bminch/smu2/README.md

# smu2
USB Source Measure Unit Design Files and Source Code
