bminch/smu2/board/smu2_BoM.ods

Item | Reference Designators | Value | Description | Qty | Digikey Catalog # | Manufacturer Part #
1 | C4, C5, C6, C7, C8, C9, C14, C18, C19, C20, C21, C22, C23, C24, C25, C26, C27, C28, C29, C30, C31, C33, C34, C35, C36, C37, C38, C39, C40, C41, C42, C43, C44, C45, C46, C47, C48, C49, C50, C52, C53, C54, C55, C58, C69 | 0.1µF | 0.1µF ceramic cap, 0603, ±5%, X7R, 50V | 45 | 1276-1033-1-ND | CL10B104JB8NNNC
2 | C1, C15, C16, C17, C56, C57, C59, C63, C64, C67, C68 | 10µF | 10µF ceramic cap, 0603, ±10%, X5R, 25V | 11 | 490-18214-1-ND | GRM188R61E106KA73D
3 | C10, C11, C12, C13 | 1µF | 1µF ceramic cap, 0603, ±10%, X7R, 25V | 4 | 1276-1184-1-ND | CL10B105KA8NNNC
4 | C60, C65, C66 | 10nF | 10nF ceramic cap, 0603, ±5%, X7R, 50V | 3 | 399-C0603C103J5RAC7867CT-ND | C0603C103J5RAC7867
5 | C2, C3 | 22pF | 22pF ceramic cap, 0603, ±1%, C0G/NP0, 50V | 2 | 1292-1500-1-ND | 0603N220F500CT
6 | C32, C51 | 1nF | 1nF ceramic cap, 0603, ±1%, C0G/NP0, 50V | 2 | 478-KGM15ACG1H102FTCT-ND | KGM15ACG1H102FT
7 | C61 | 220nF | 220nF ceramic cap, 0603, ±10%, X7R, 50V | 1 | 445-7408-1-ND | C1608X7R1H224K080AB
8 | C62 | 4.7nF | 4.7nF ceramic cap 0603, ±10%, X7R, 50V | 1 | 1276-1098-1-ND | CL10B472KB8NNNC
9 | R11, R12, R14, R16, R21, R22, R23, R24, R25, R26, R39, R41, R46, R47, R48, R49, R50, R51, R71, R72, R73, R74 | 2kΩ | 2kΩ resistor, 0603, ±0.1%, 1/10W | 22 | P2.0KDBCT-ND | ERA-3AEB202V
10 | R2, R4, R5, R6, R7, R9, R63 | 5.1kΩ | 5.1kΩ resistor, 0603, ±1%, 1/10W | 7 | P5.10KHCT-ND | ERJ-3EKF5101V
11 | R19, R20, R29, R44, R45, R54 | 1kΩ | 1kΩ resistor, 0603, ±0.1%, 1/10W | 6 | P1.0KDBCT-ND | ERA-3AEB102V
12 | R17, R18, R42, R43, R70 | 12.7kΩ | 12.7kΩ resistor, 0603, ±1%, 1/10W | 5 | 311-12.7KHRCT-ND | RC0603FR-0712K7L
13 | R1, R3, R10, R65 | 909Ω | 909Ω resistor, 0603, ±1%, 1/10W | 4 | 311-909HRCT-ND | RC0603FR-07909RL
14 | R13, R15, R38, R40 | 255Ω | 255Ω resistor, 0603, ±0.1%, 1/10W | 4 | P255DBCT-ND | ERA-3AEB2550V
15 | R30, R34, R55, R59 | 316Ω | 316Ω resistor, 0603, ±0.1%, 1/10W | 4 | P316DBCT-ND | ERA-3AEB3160V
16 | R31, R35, R56, R60 | 10kΩ | 10kΩ resistor, 0603, ±0.1%, 1/10W | 4 | P10KDBCT-ND | ERA-3AEB103V
17 | R32, R36, R57, R61 | 316kΩ | 316kΩ resistor, 0603, ±0.1%, 1/10W | 4 | P316KDBCT-ND | ERA-3AEB3163V
18 | R33, R37, R58, R62 | 10MΩ | 10MΩ resistor, 1206, ±0.1%, 1/4W | 4 | 749-MCA1206MD1005BP100CT-ND | MCA1206MD1005BP100
19 | R8, R66 | 105kΩ | 105kΩ resistor, 0603, ±1%, 1/10W | 2 | 311-105KHRCT-ND | RC0603FR-07105KL
20 | R27, R52 | 909kΩ | 909kΩ resistor, 0603, ±1%, 1/10W | 2 | 311-909KHRCT-ND | RC0603FR-07909KL
21 | R28, R53 | 9.09kΩ | 9.09kΩ resistor, 0603, ±0.1%, 1/10W | 2 | P9.09KDBCT-ND | ERA-3AEB9091V
22 | R64 | 100Ω | 100Ω resistor, 0603, ±1%, 1/10W | 1 | 311-100HRCT-ND | RC0603FR-07100RL
23 | R67 | 1.3MΩ | 1.3MΩ resistor, 0603, ±1%, 1/10W | 1 | YAG3326CT-ND | RC0603FR-071M3L
24 | R68 | 976kΩ | 976kΩ resistor, 0603, ±1%, 1/10W | 1 | 311-976KHRCT-ND | RC0603FR-07976KL
25 | R69 | 86.6kΩ | 86.6kΩ resistor, 0603, ±1%, 1/10W | 1 | 311-86.6KHRCT-ND | RC0603FR-0786K6L
26 | L1, L2 | 4.7µH | PA5003.182NLT | 2 | 553-4090-1-ND | PA5003.472NLT
27 | D4, D5 | SD0805S020S1R0 | 0805, 20V, 1A, Schottky diode | 2 | 478-7800-1-ND | SD0805S020S1R0
28 | D1 | RGB | IN-S85TATRGB | 1 | 1830-1086-1-ND | IN-S85TATRGB
29 | D2, D6 | BLE, ±12V | 0805, Blue LED | 2 | 1497-XZCFBB54W-1VFCT-ND | XZCFBB54W-1VF
30 | D3 | 3V3 | 0805, Green LED | 1 | 160-1887-1-ND | LTST-C170TGKT
31 | U6, U7, U9, U10, U15, U16, U18, U19 | AD8420 | MSOP-8, 3x3mm, 0.65mm pitch | 8 | 505-AD8420ARMZ-R7CT-ND | AD8420ARMZ-R7
32 | U11, U12, U20, U21 | ADG509F | TSSOP-16, 4.4x5mm, 0.65mm pitch | 4 | 505-ADG5209FBRUZ-RL7CT-ND | ADG5209FBRUZ-RL7
33 | U2, U3 | ADS8887 | TSSOP-10, 3x3mm, 0.5mm pitch | 2 | 296-37909-5-ND | ADS8887IDGS
34 | U8, U17 | ADG333A | SSOP-20, 5.3x7.2mm, 0.65mm pitch | 2 | ADG333ABRSZ-REELCT-ND | ADG333ABRSZ-REEL
35 | U13, U22 | AD823A | MSOP-8, 3x3mm, 0.65mm pitch | 2 | 505-AD823AARMZ-ND | AD823AARMZ
36 | U14, U23 | ADG1221 | MSOP-10, 3x3mm, 0.5mm pitch | 2 | 505-ADG1221BRMZ-REEL7CT-ND | ADG1221BRMZ-REEL7
37 | U1 | PIC24FJ128GC006 |  | 1 | PIC24FJ128GC006-I/MR-ND | PIC24FJ128GC006-I/MR
38 | U4 | DAC8564 | TSSOP-16, 4.4x5mm, 0.65mm pitch | 1 | 296-50721-1-ND | DAC8564IAPWR
39 | U5 | RN4871 | RN4871 | 1 | RN4871-I/RM130-ND | RN4871-I/RM130
40 | U24 | MCP1702T-3302E | SOT-23 | 1 | MCP1702T-3302E/CBCT-ND | MCP1702T-3302E/CB
41 | U25 | TPS65131-Q1 | TPS65131-Q_1 | 1 | 296-40865-1-ND | TPS65131TRGERQ1
42 | U26 | LT3032EDE-12 |  | 1 | LT3032EDE-12#PBF-ND | LT3032EDE-12#PBF
43 | U27 | MCP6022 | TSSOP-8, 4.4x3mm, 0.65mm pitch | 1 | MCP6022T-I/STCT-ND | MCP6022T-I/ST
44 | Y1 | 32.768kHz | Crystal_SMD_2012-2Pin_2.0x1.2mm | 1 | XC2738-CT-ND | ECS-.327-12.5-12R-C-TR
45 | Q1 | AOSS21115C | SOT-23 | 1 | 785-AOSS21115CCT-ND | AOSS21115C
46 | S1, S2 | RST, SW1 | KXT321LHS | 2 | CKN10778CT-ND | KTX 321 LHS
47 | J2 | USB4105-GF-A | USB4105-GF-A | 1 | 2073-USB4105-GF-ACT-ND | USB4105-GF-A
48 | J3, J4, J5, J6 | 2.54-mm pin header | 2 1x2, 2 1x6 2.54-mm vertical male pin headers | 1 | S1021E-36-ND | PBC36SABN
49 |  | USB cable | USB A to C cable, USB 2.0, 1m | 1 | 2987-DH-20M50052-ND | DH-20M50052
50 |  | Breadboard | Solderless breadboard | 1 | 438-1045-ND | TW-E40-1020
