bminch/smu2/board/Eclectronics/3dshapes/219-3M.STEP

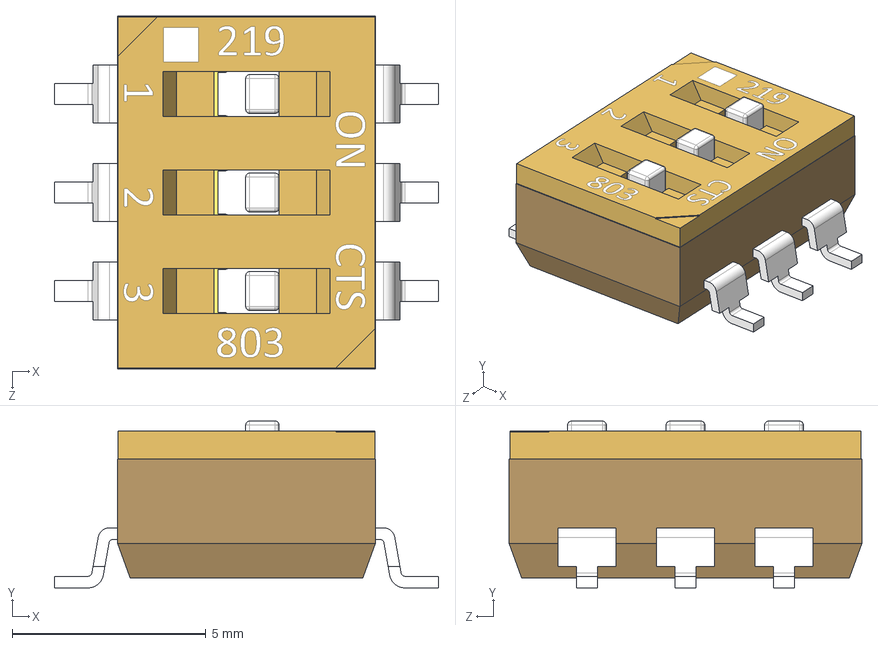
[picture p1: CAD file, 2025-06-17]
board/Eclectronics/3dshapes/219-3M.STEP
9.91 x 4.30 x 9.10 mm
