bminch/smu2/board/Eclectronics/3dshapes/STP_831056289_rev1.stp

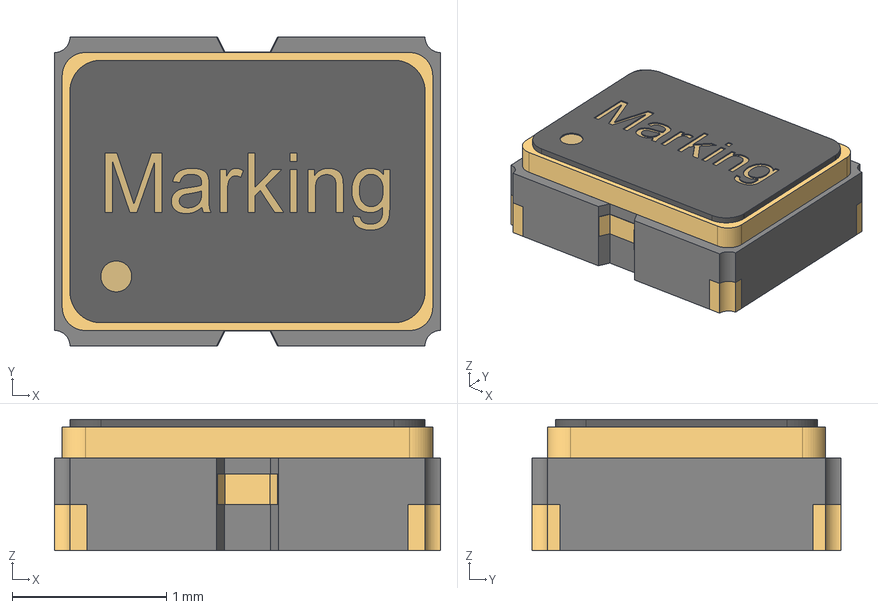
[picture p2: CAD file, 2025-06-17]
board/Eclectronics/3dshapes/STP_831056289_rev1.stp
2.50 x 2.00 x 0.85 mm
Pins
Cover
