bminch/smu2/board/Eclectronics/3dshapes/WS2812-2020.STEP

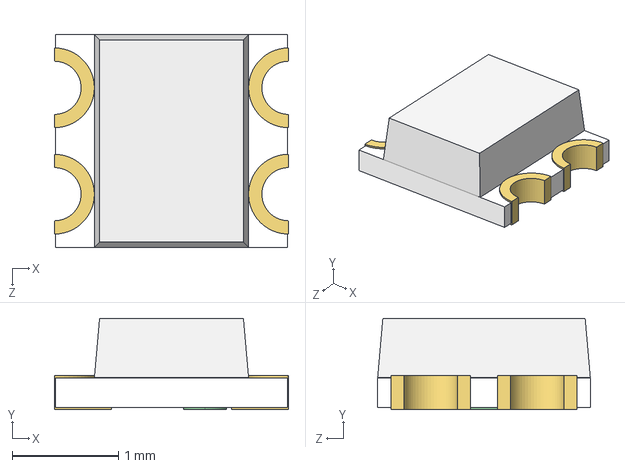
[picture p3: CAD file, 2025-06-17]
board/Eclectronics/3dshapes/WS2812-2020.STEP
2.20 x 0.86 x 2.00 mm
