bminch/smu2/board/Eclectronics/3dshapes/PA5003.182NLT.step

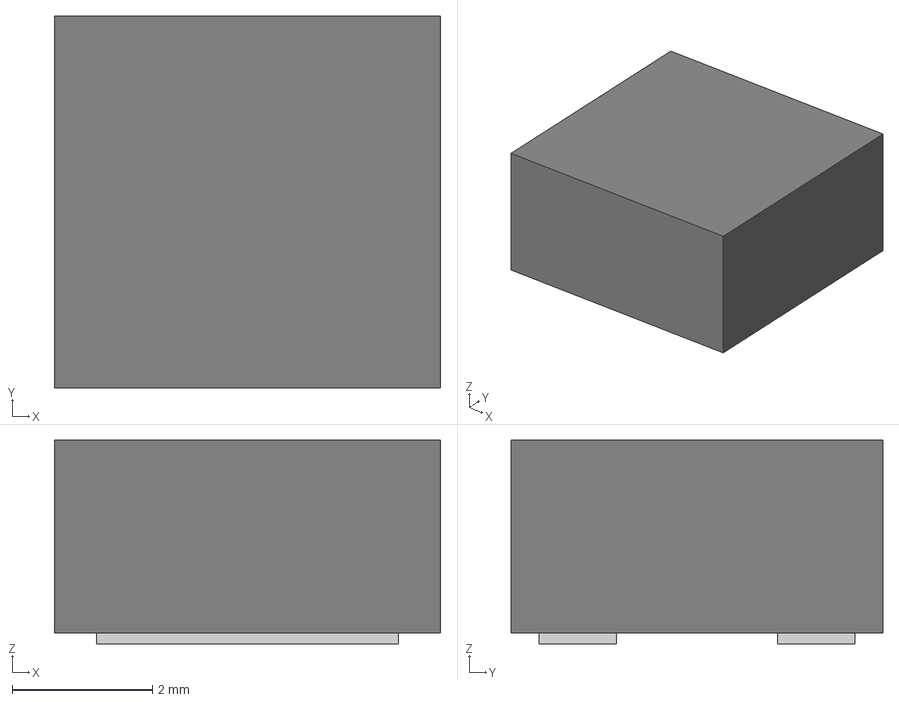
[picture p4: CAD file, 2025-06-17]
board/Eclectronics/3dshapes/PA5003.182NLT.step
5.50 x 5.30 x 2.90 mm
