bminch/smu2/board/Eclectronics/3dshapes/CUI_SDS-50J.step

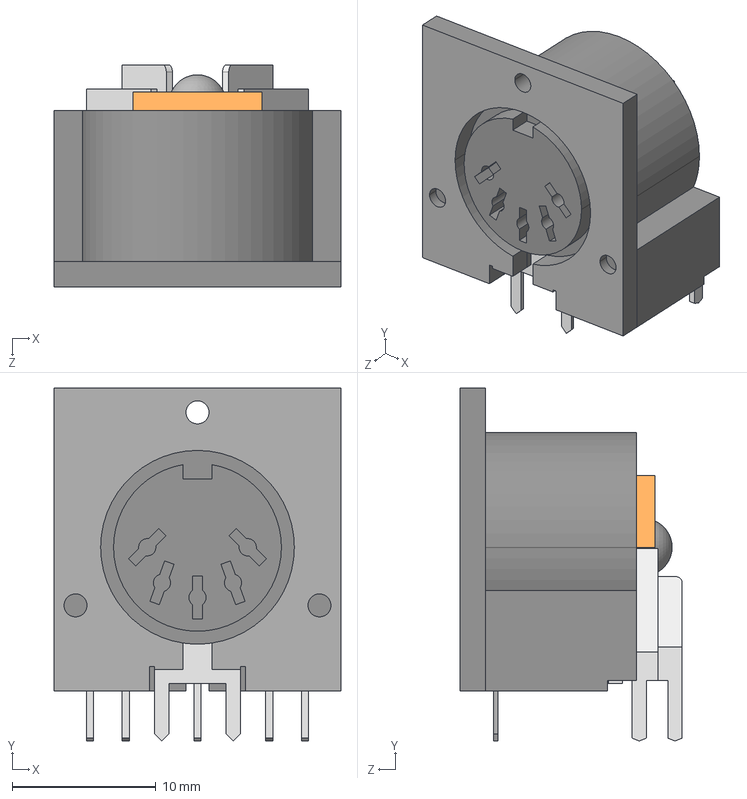
[picture p5: CAD file, 2025-06-17]
board/Eclectronics/3dshapes/CUI_SDS-50J.step
20.0 x 24.6 x 15.5 mm
