bminch/smu2/board/Eclectronics/3dshapes/WSON8-6x5.STEP

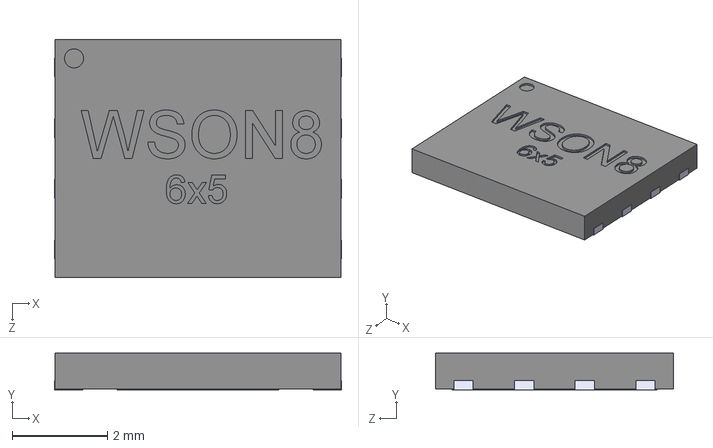
[picture p7: CAD file, 2025-06-17]
board/Eclectronics/3dshapes/WSON8-6x5.STEP
6.02 x 0.77 x 5.00 mm
