bminch/smu2/board/Eclectronics/3dshapes/DFN1006-2.stp

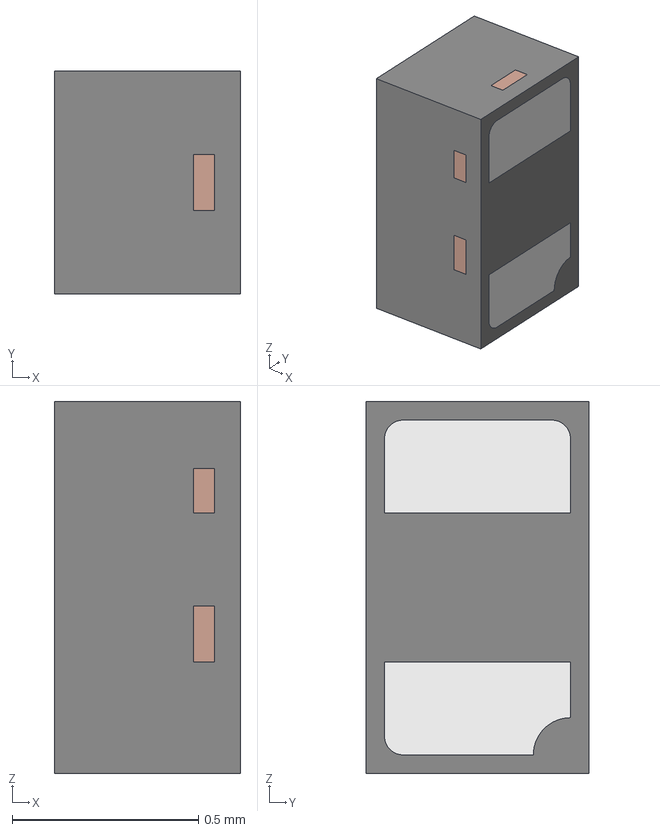
[picture p8: CAD file, 2025-06-17]
board/Eclectronics/3dshapes/DFN1006-2.stp
0.5 x 0.6 x 1.00 mm
LDF
