bminch/smu2/board/Eclectronics/3dshapes/EEEFTH101XAL.step

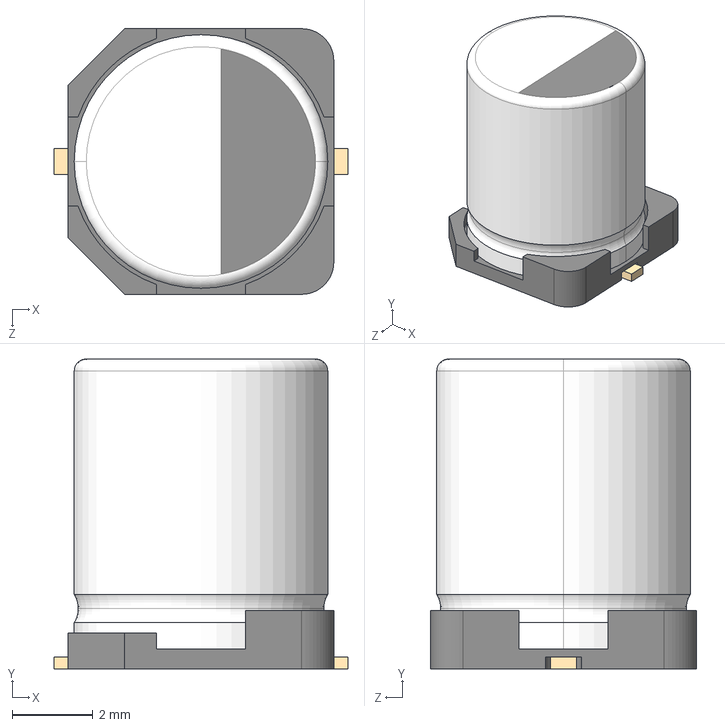
[picture p9: CAD file, 2025-06-17]
board/Eclectronics/3dshapes/EEEFTH101XAL.step
7.30 x 7.70 x 6.60 mm
