bminch/smu2/board/Eclectronics/3dshapes/ABM10.STP

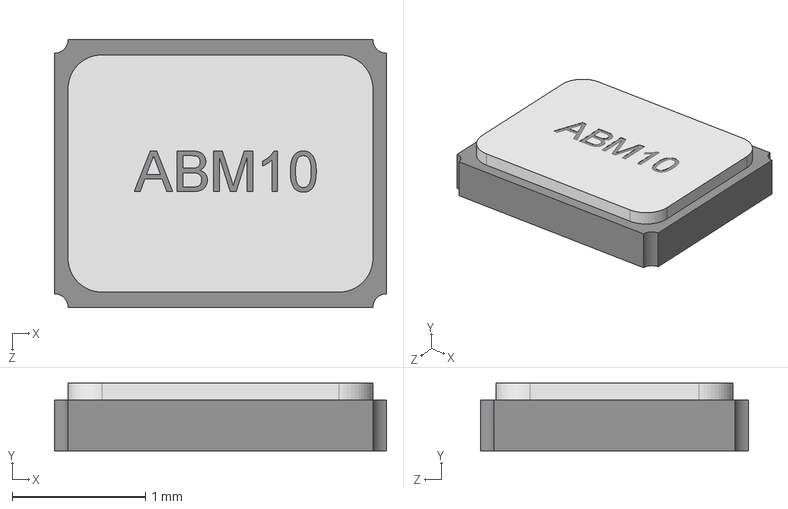
[picture p10: CAD file, 2025-06-17]
board/Eclectronics/3dshapes/ABM10.STP
2.49 x 0.508 x 2.01 mm
