bminch/smu2/board/Eclectronics/3dshapes/3382g-001-xxx.stp

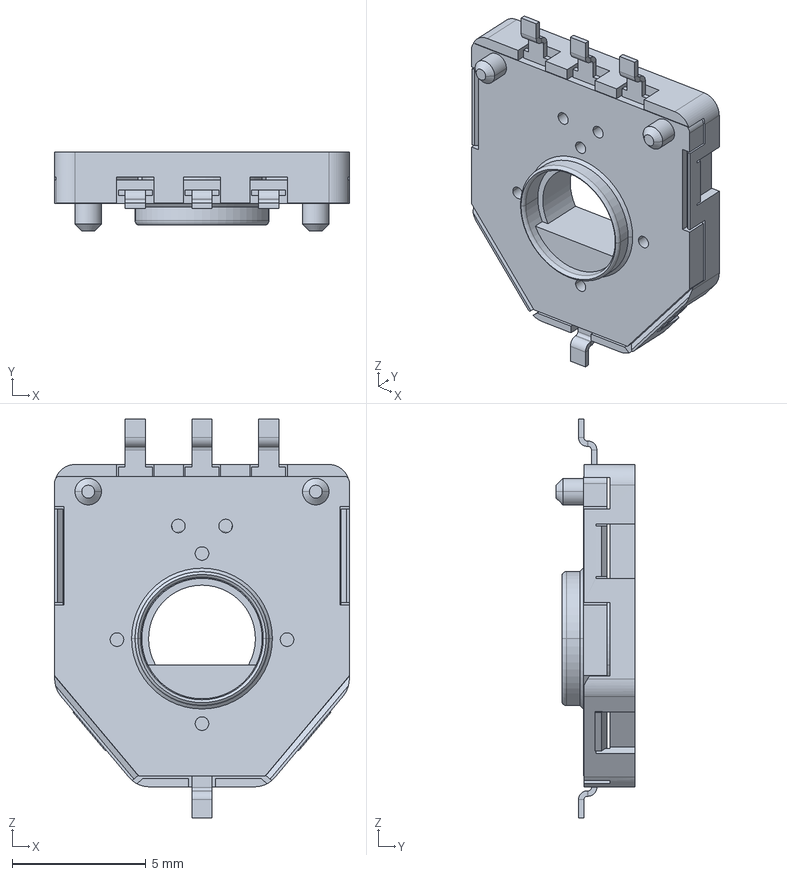
[picture p11: CAD file, 2025-06-17]
board/Eclectronics/3dshapes/3382g-001-xxx.stp
11.0 x 2.95 x 14.9 mm
