bminch/smu2/board/Eclectronics/3dshapes/USB4505-03-0-A_REVA.step

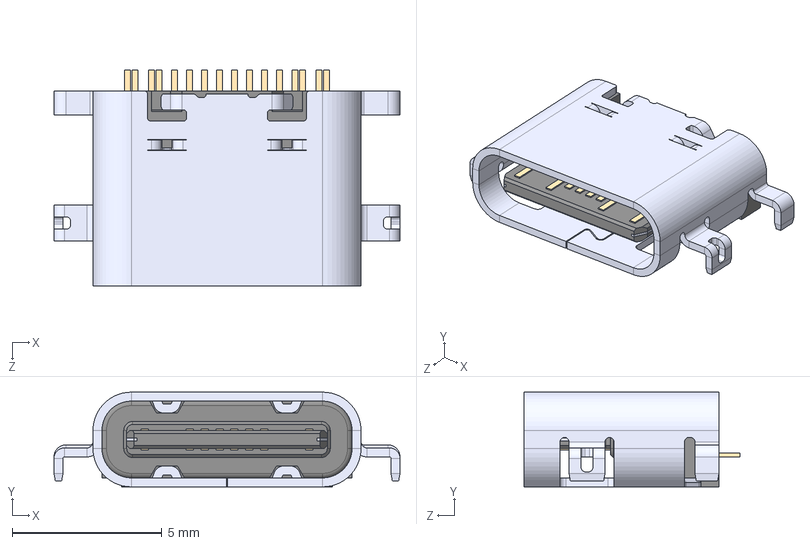
[picture p13: CAD file, 2025-06-17]
board/Eclectronics/3dshapes/USB4505-03-0-A_REVA.step
11.5 x 3.16 x 7.20 mm
