bminch/smu2/board/Eclectronics/3dshapes/S4B-PH-SM4-TB.stp

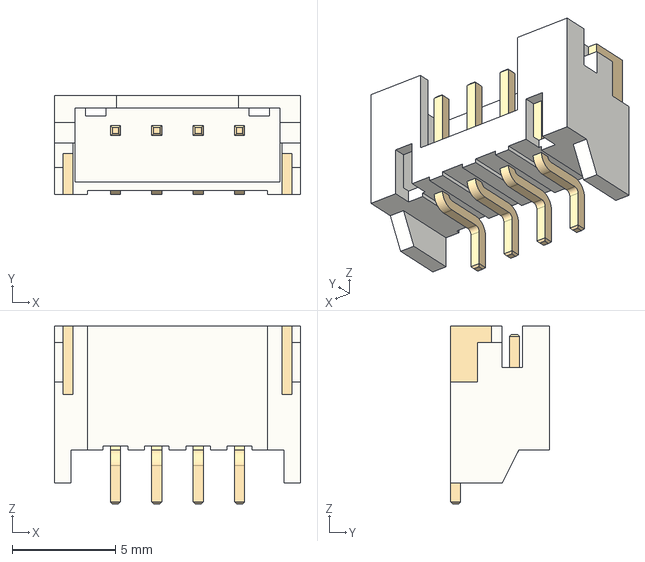
[picture p14: CAD file, 2025-06-17]
board/Eclectronics/3dshapes/S4B-PH-SM4-TB.stp
11.9 x 4.80 x 8.60 mm
