bminch/smu2/board/Eclectronics/3dshapes/SJ-3524-SMT-TR-BE.step

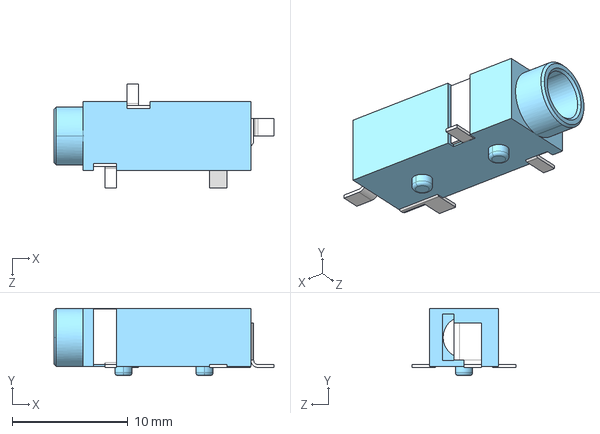
[picture p15: CAD file, 2025-06-17]
board/Eclectronics/3dshapes/SJ-3524-SMT-TR-BE.step
19.0 x 5.80 x 9.00 mm
