bminch/smu2/board/Eclectronics/3dshapes/TL3301AFxxxxJ.stp

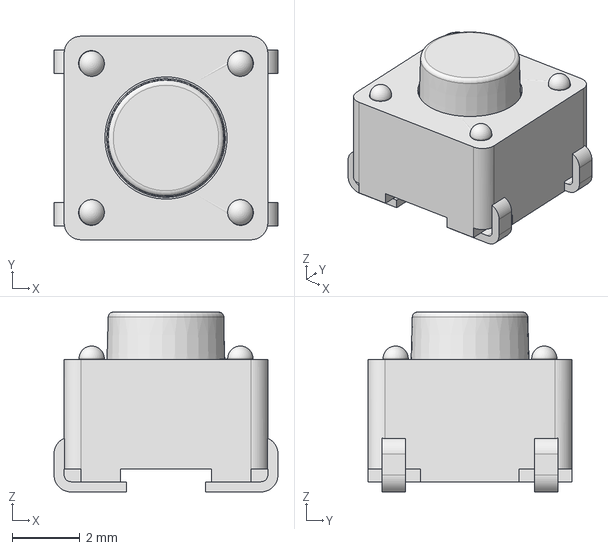
[picture p16: CAD file, 2025-06-17]
board/Eclectronics/3dshapes/TL3301AFxxxxJ.stp
6.60 x 6.00 x 5.30 mm
