bminch/smu2/board/Eclectronics/3dshapes/UFQFPN48.stp

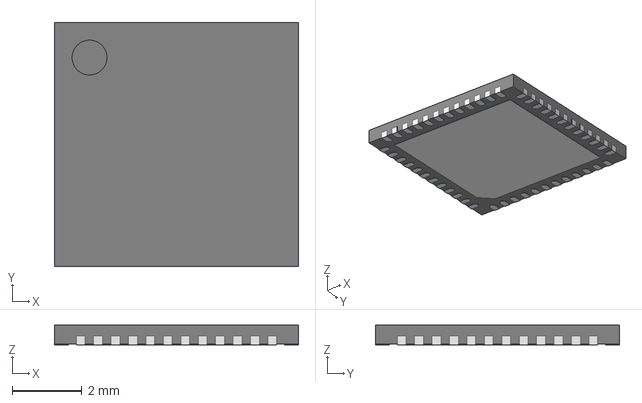
[picture p17: CAD file, 2025-06-17]
board/Eclectronics/3dshapes/UFQFPN48.stp
7.00 x 7.00 x 0.57 mm
