bminch/smu2/board/Eclectronics/3dshapes/CUI_DEVICES_PJ-202A.step

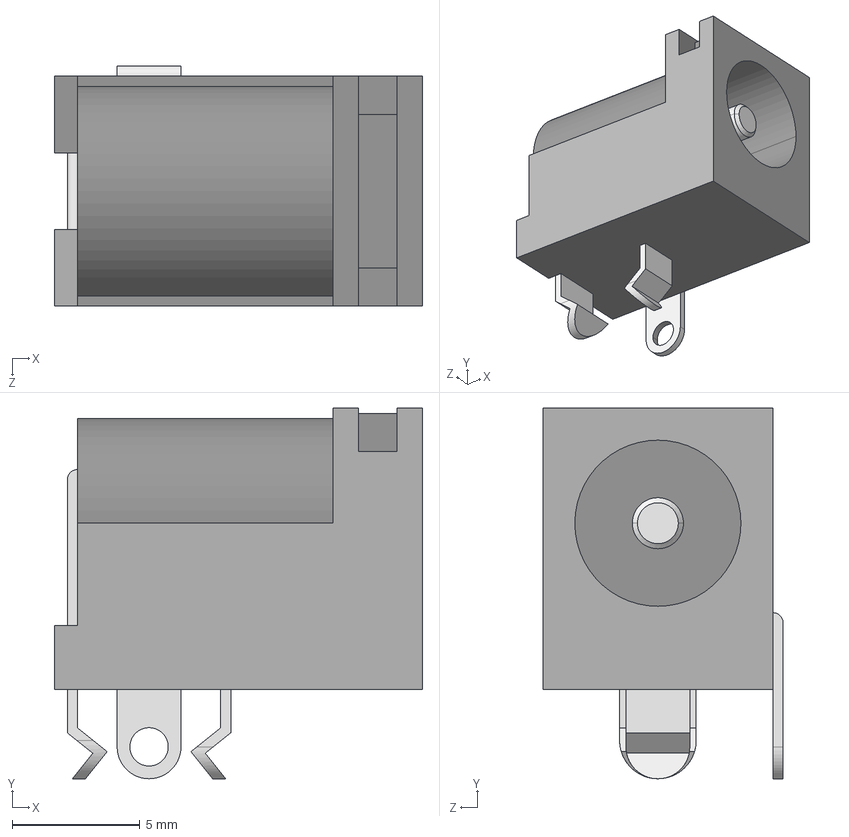
[picture p18: CAD file, 2025-06-17]
board/Eclectronics/3dshapes/CUI_DEVICES_PJ-202A.step
14.4 x 14.5 x 9.40 mm
