bminch/smu2/board/Eclectronics/3dshapes/B4B-XH-A.step

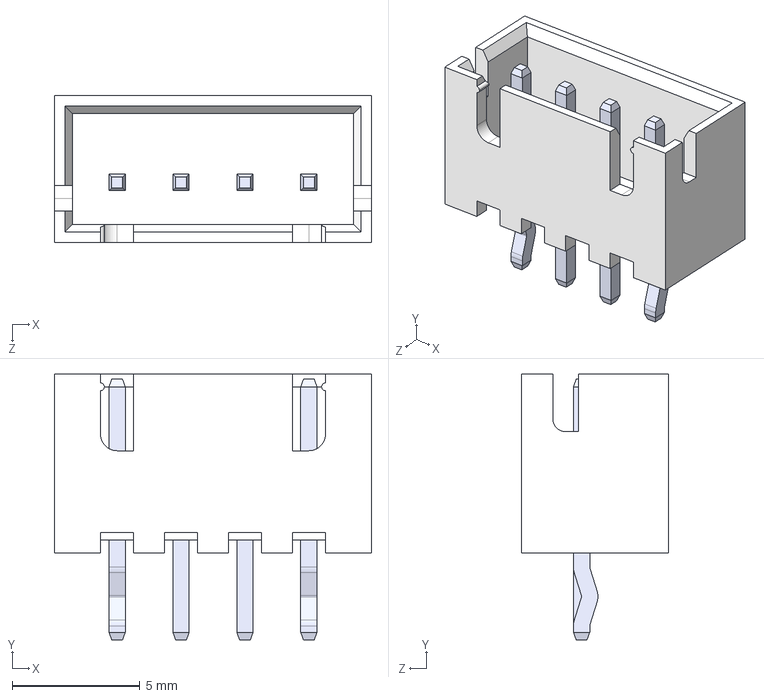
[picture p19: CAD file, 2025-06-17]
board/Eclectronics/3dshapes/B4B-XH-A.step
12.4 x 10.4 x 5.75 mm
