bminch/smu2/board/Eclectronics/3dshapes/RNR0011A.stp

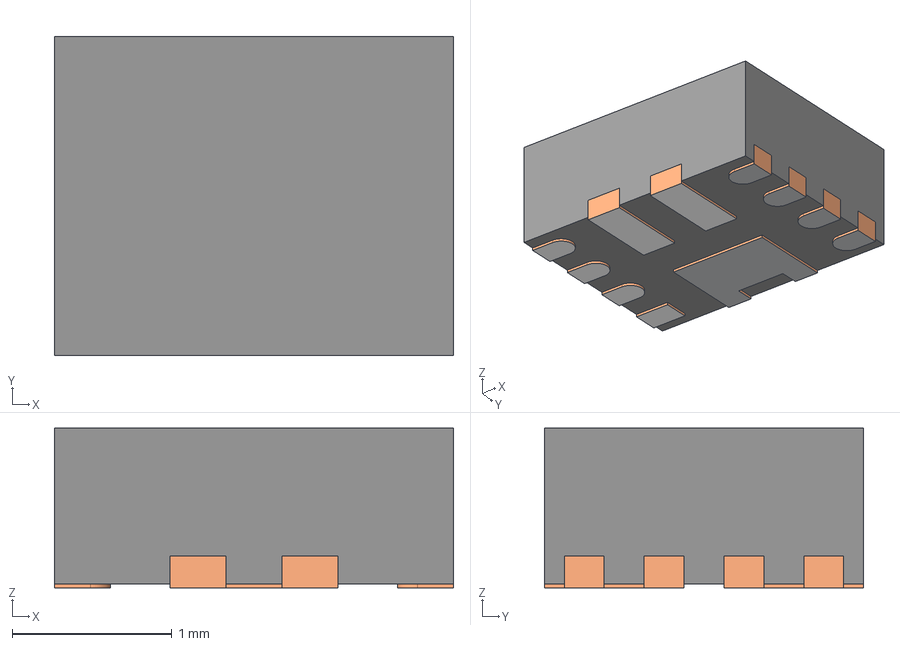
[picture p20: CAD file, 2025-06-17]
board/Eclectronics/3dshapes/RNR0011A.stp
2.50 x 2.00 x 1.00 mm
FRAME-RNR0011A
BODY-QFN
PIN1-ID
