bminch/smu2/board/Eclectronics/3dshapes/RTE0020A.stp

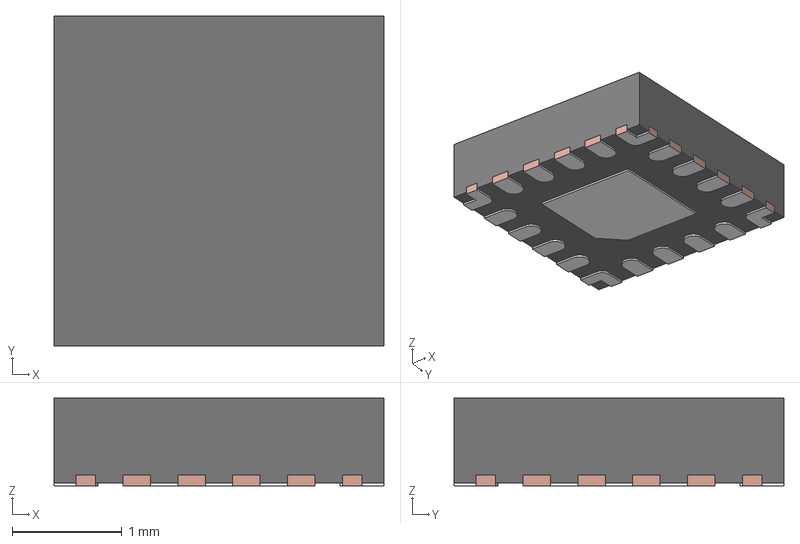
[picture p21: CAD file, 2025-06-17]
board/Eclectronics/3dshapes/RTE0020A.stp
3.00 x 3.00 x 0.8 mm
FRAME
