bminch/smu2/board/Eclectronics/3dshapes/BarrelJack.STEP

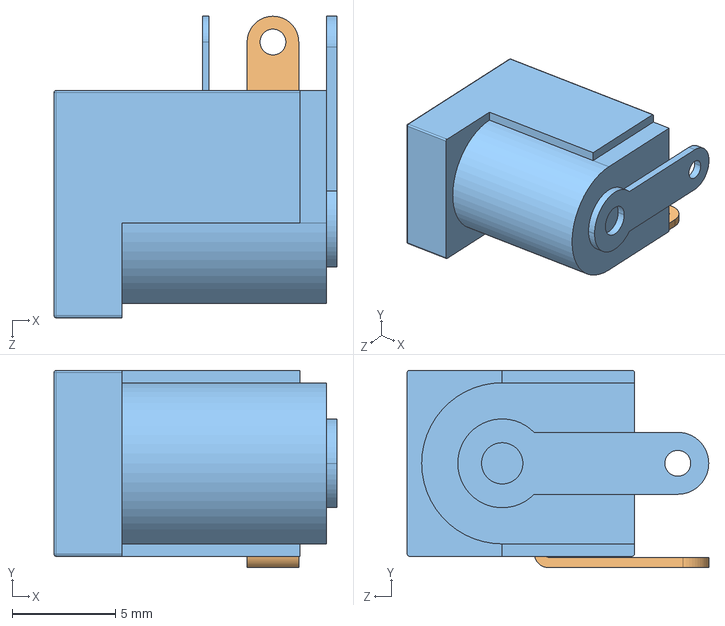
[picture p22: CAD file, 2025-06-17]
board/Eclectronics/3dshapes/BarrelJack.STEP
13.7 x 9.55 x 14.6 mm
