bminch/smu2/board/Eclectronics/3dshapes/DFN8_3x3_0.65.step

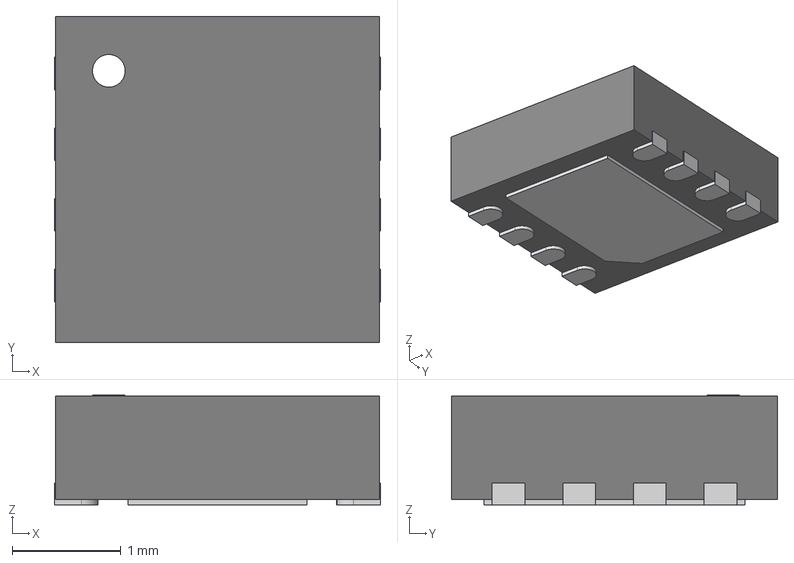
[picture p23: CAD file, 2025-06-17]
board/Eclectronics/3dshapes/DFN8_3x3_0.65.step
3.00 x 3.00 x 1.01 mm
