bminch/smu2/board/Eclectronics/3dshapes/KXT321LHS.stp

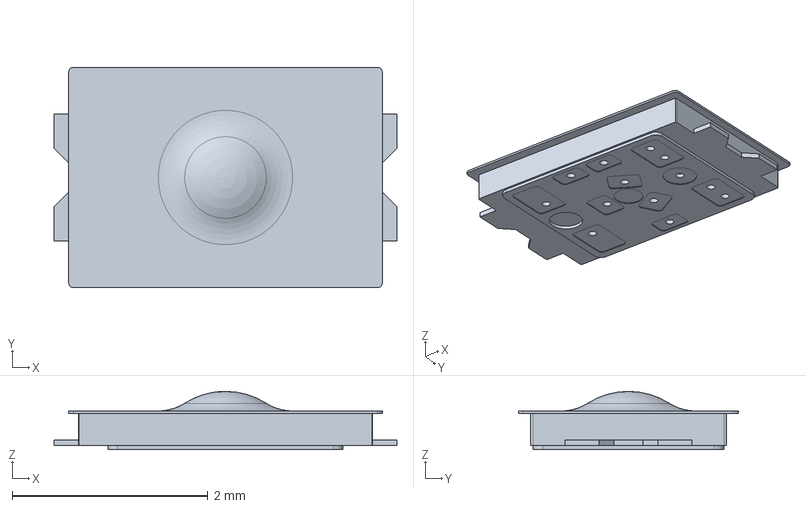
[picture p24: CAD file, 2025-06-17]
board/Eclectronics/3dshapes/KXT321LHS.stp
3.50 x 2.25 x 0.595 mm
