bminch/smu2/board/Eclectronics/3dshapes/RP2040_QFN_PACKAGE.STEP

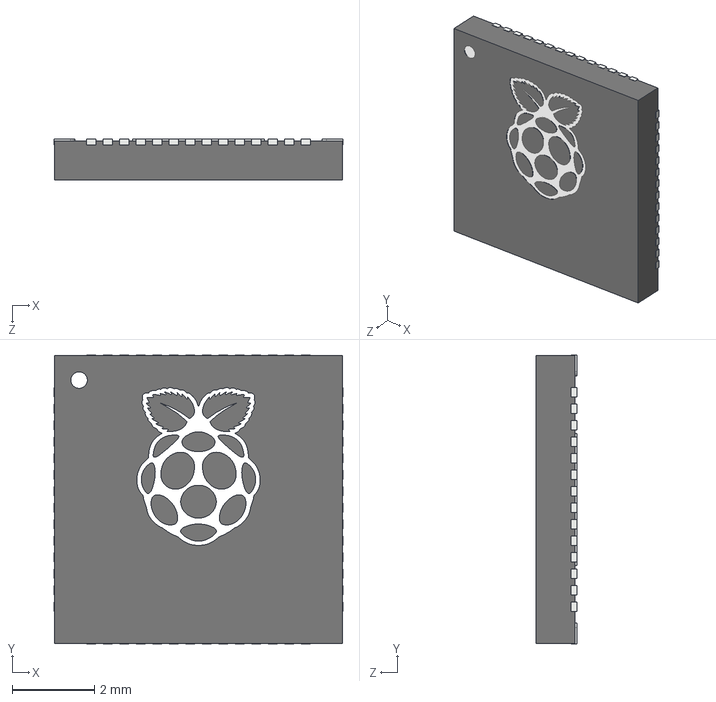
[picture p25: CAD file, 2025-06-17]
board/Eclectronics/3dshapes/RP2040_QFN_PACKAGE.STEP
7.02 x 7.02 x 1.00 mm
