bminch/smu2/board/Eclectronics/3dshapes/IN-S85TATRGB.stp

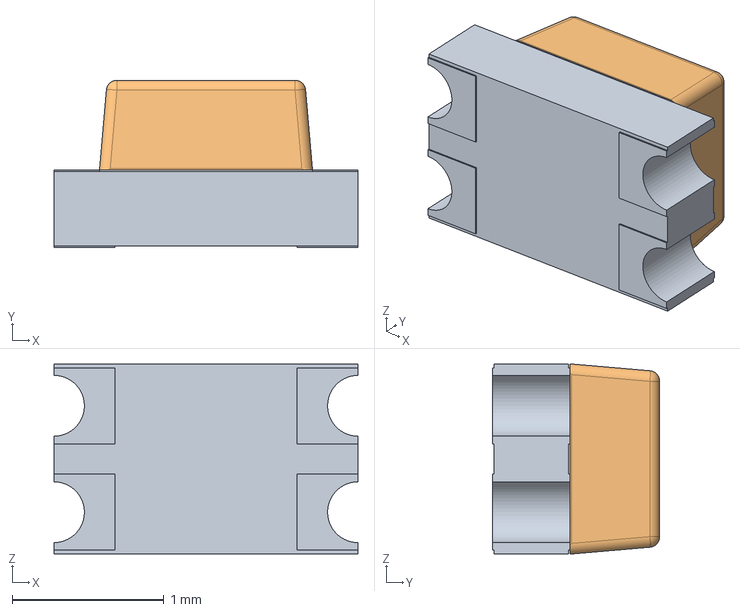
[picture p26: CAD file, 2025-06-17]
board/Eclectronics/3dshapes/IN-S85TATRGB.stp
2.00 x 1.10 x 1.25 mm
