bminch/smu2/board/Eclectronics/3dshapes/ABS06-107.STP

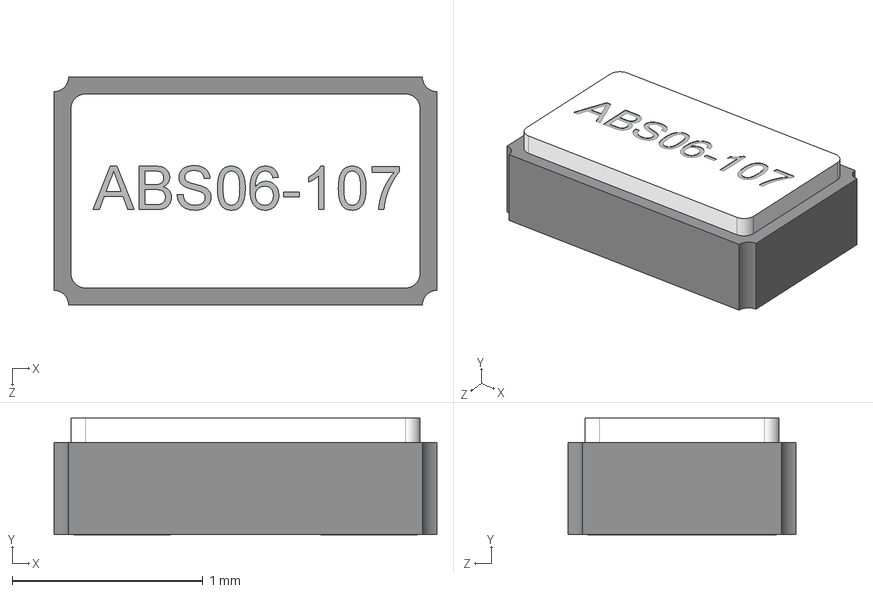
[picture p27: CAD file, 2025-06-17]
board/Eclectronics/3dshapes/ABS06-107.STP
2.01 x 0.612 x 1.19 mm
