bminch/smu2/board/Eclectronics/3dshapes/TL3301NFxxxxJ.stp

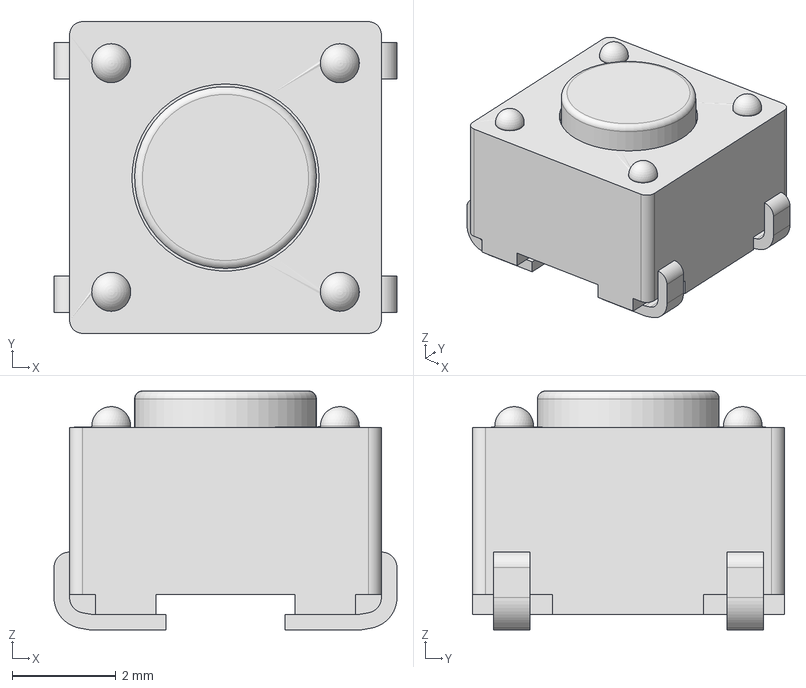
[picture p28: CAD file, 2025-06-17]
board/Eclectronics/3dshapes/TL3301NFxxxxJ.stp
6.60 x 6.00 x 4.60 mm
