bminch/smu2/board/Eclectronics/3dshapes/Analog_Devices_Inc_-_ADXL362BCCZ.step

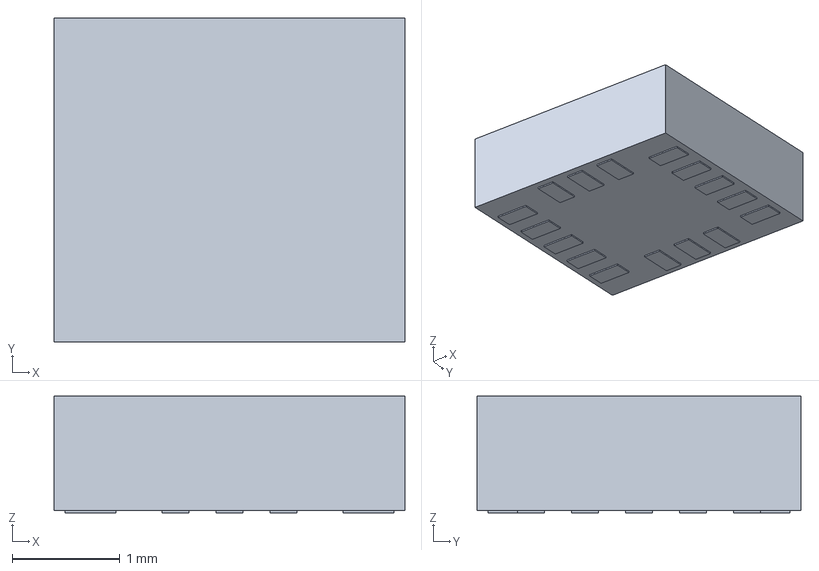
[picture p29: CAD file, 2025-06-17]
board/Eclectronics/3dshapes/Analog_Devices_Inc_-_ADXL362BCCZ.step
3.25 x 3.00 x 1.08 mm
