bminch/smu2/board/Eclectronics/3dshapes/CSTNE.step

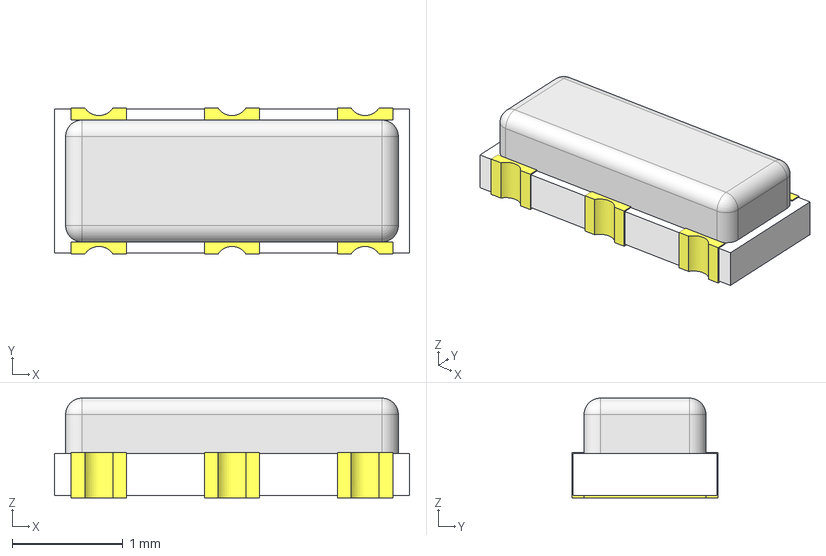
[picture p30: CAD file, 2025-06-17]
board/Eclectronics/3dshapes/CSTNE.step
3.20 x 1.32 x 0.9 mm
