bminch/smu2/board/Eclectronics/3dshapes/WS2812_RGB_LED_updated.stp

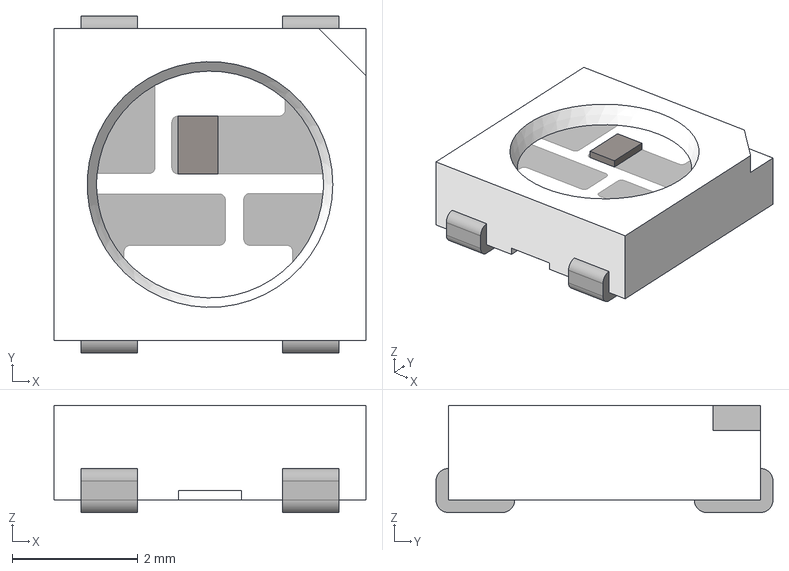
[picture p31: CAD file, 2025-06-17]
board/Eclectronics/3dshapes/WS2812_RGB_LED_updated.stp
4.95 x 5.35 x 1.70 mm
