bminch/smu2/board/Eclectronics/3dshapes/QFN-32_5x5.stp

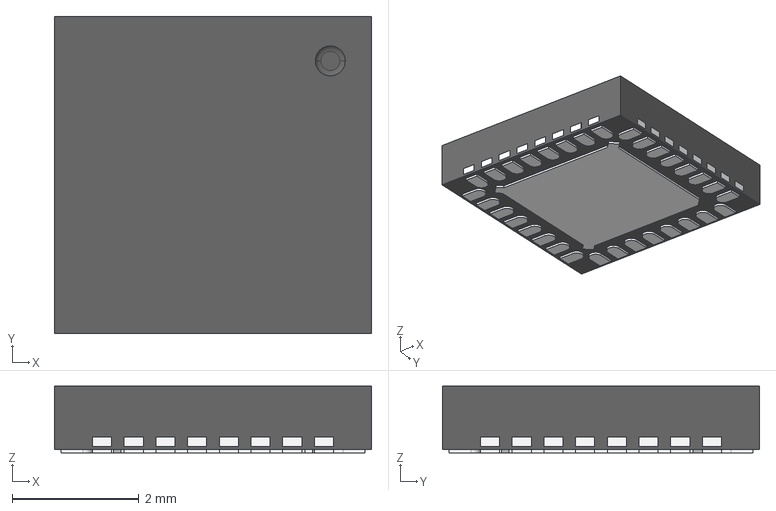
[picture p32: CAD file, 2025-06-17]
board/Eclectronics/3dshapes/QFN-32_5x5.stp
5.00 x 5.00 x 1.05 mm
