bminch/smu2/(list of files, cad)

Other CAD files:
board/Eclectronics/3dshapes/1725656.stp
board/Eclectronics/3dshapes/5442565.stp
