bminch/smu2/board/smu2_parts_sheet.pdf

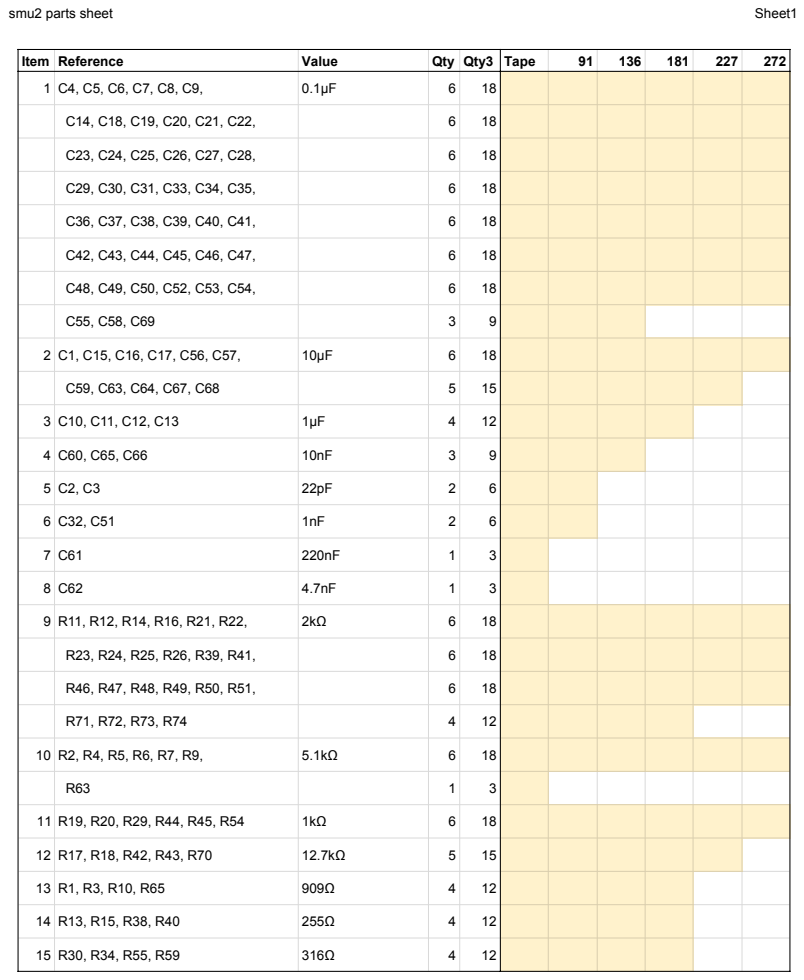
[picture p33: page 1]

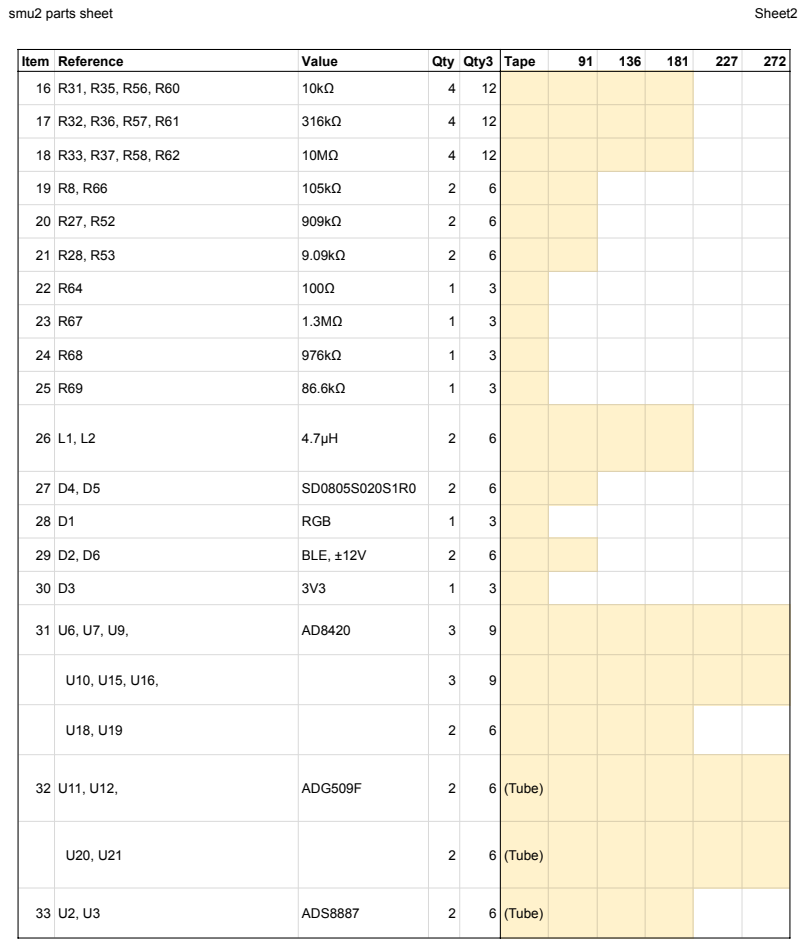
[picture p34: page 2]

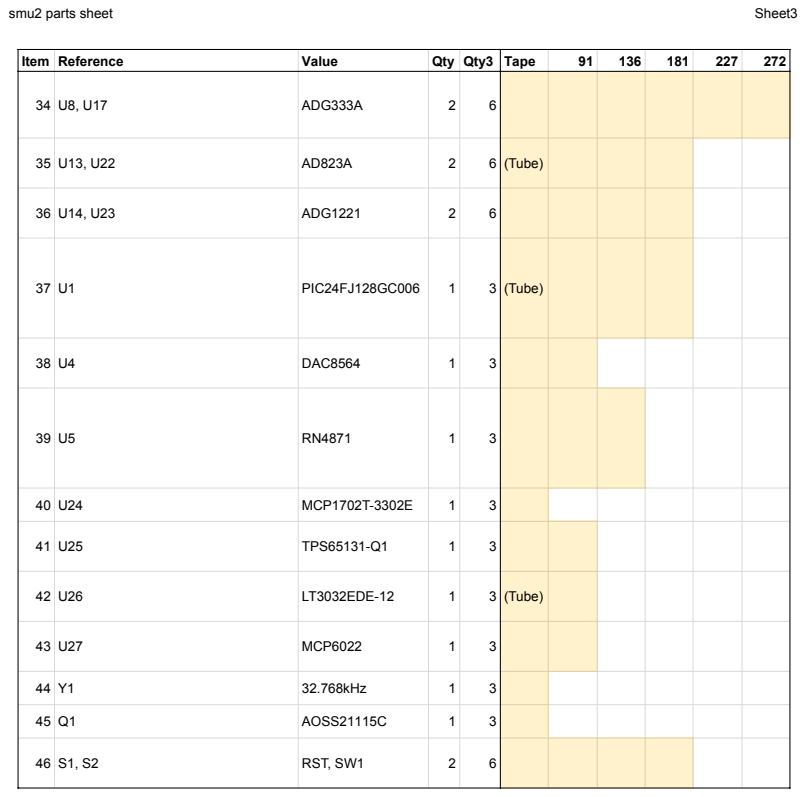
[picture p35: page 3]
