bminch/smu2/board/smu2/smu2.kicad_pcb

## KiCad design board/smu2/smu2.kicad_pcb (2025-06-20)

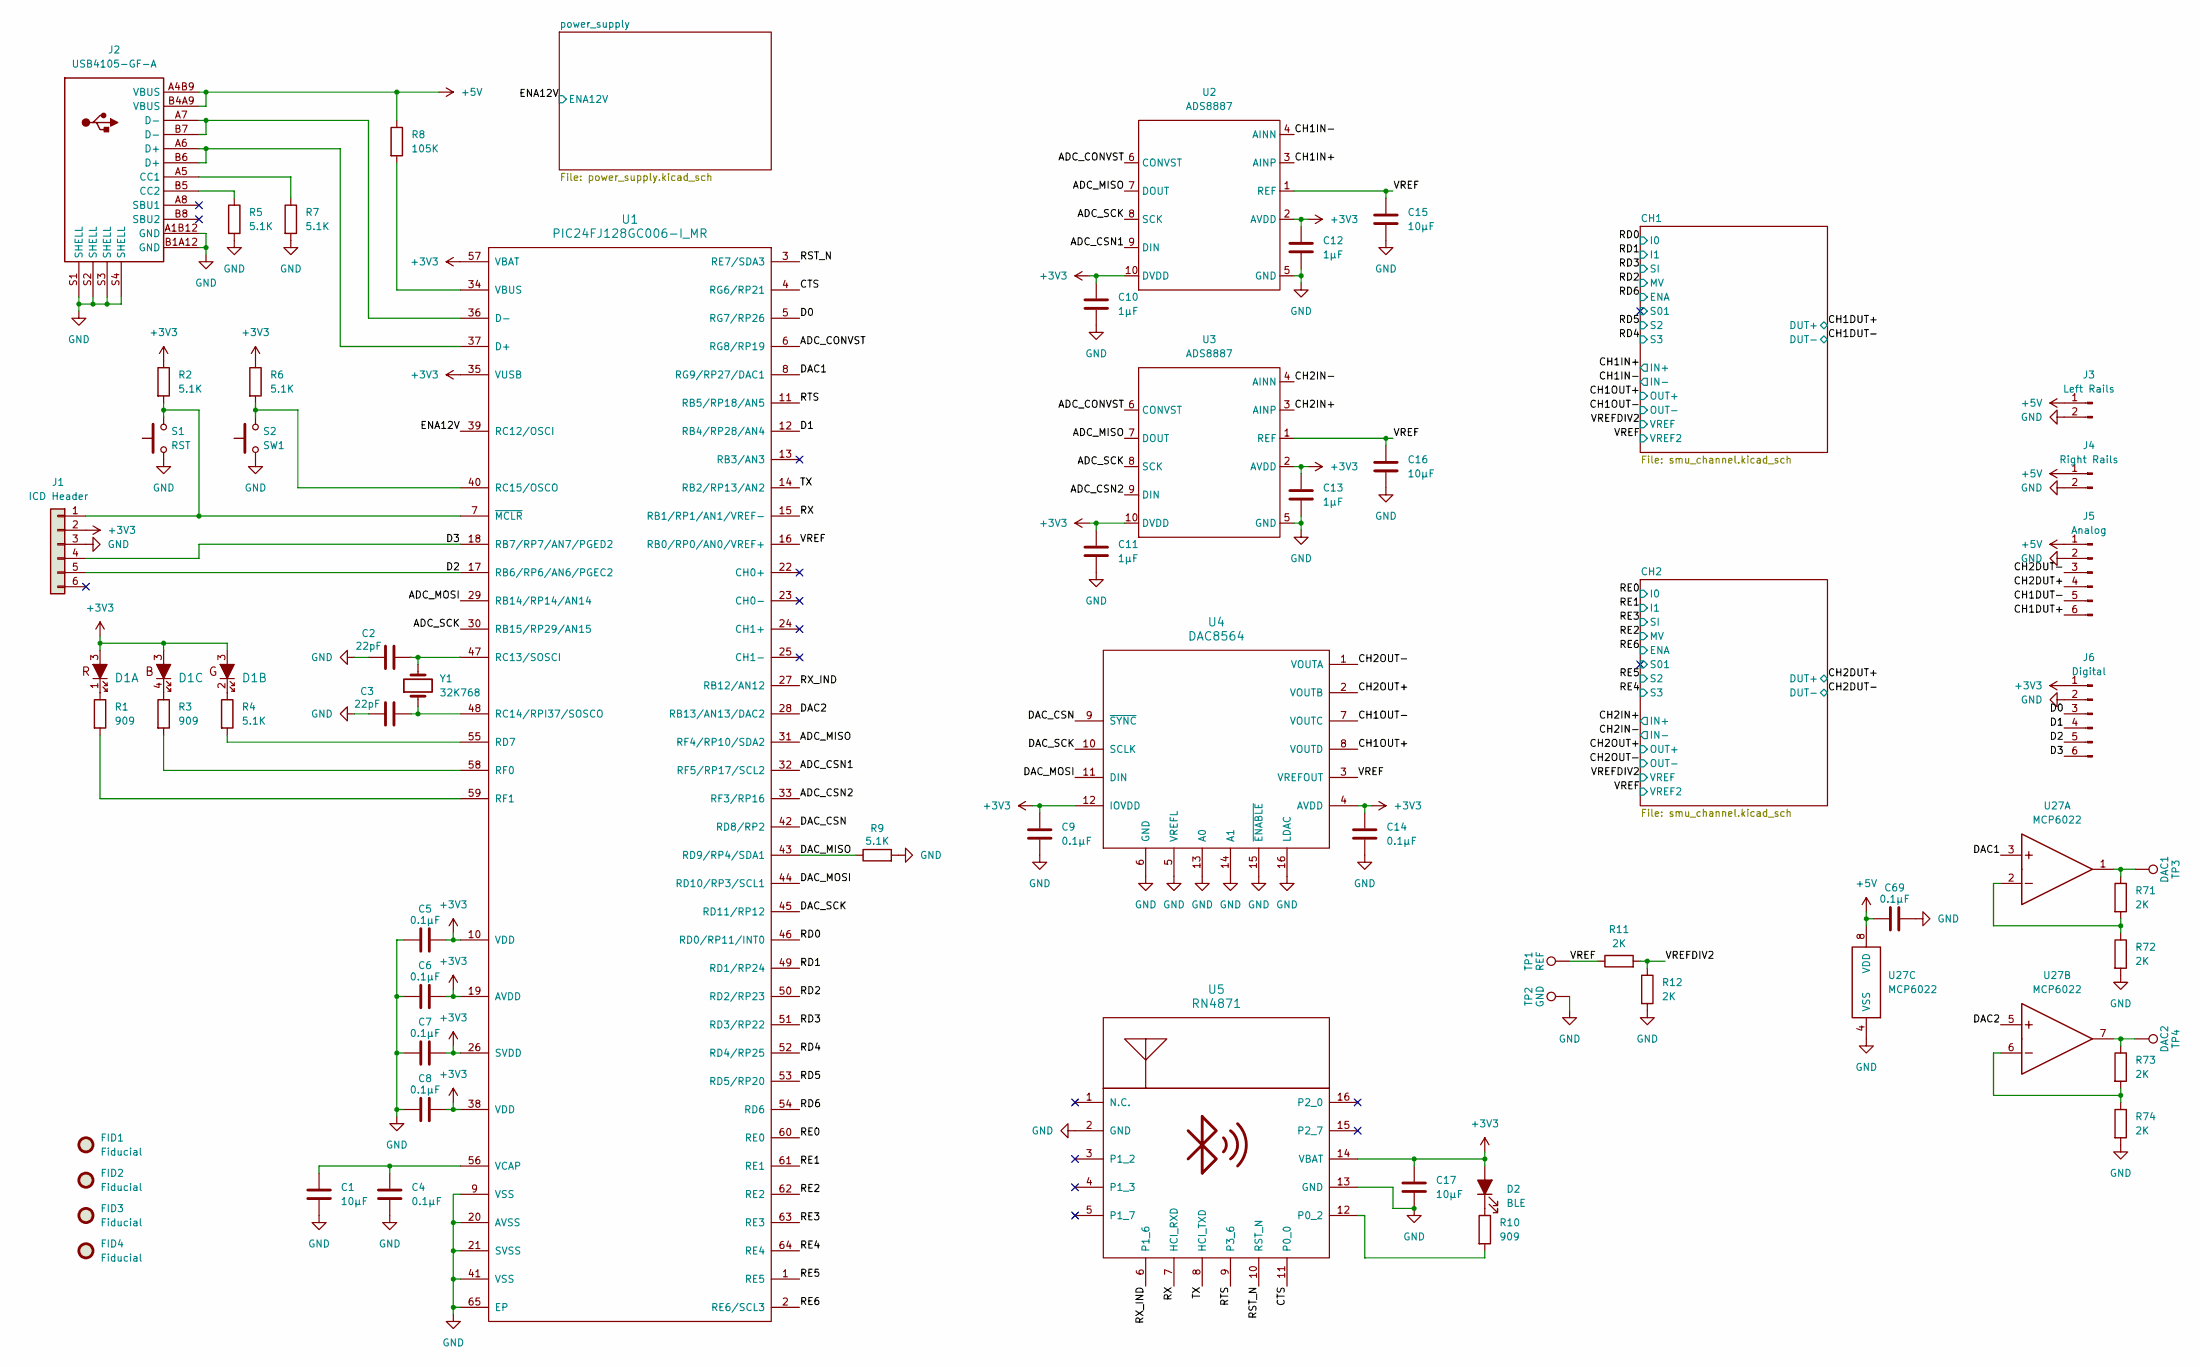
[picture p40: schematic smu2.kicad_sch, SMU 2.0]

Parts:
C1, C15, C16, C17: 10µF; C_0603_1608Metric
C2, C3: 22pF; C_0603_1608Metric
C4, C5, C6, C7, C8, C9, C14, C69: 0.1µF; C_0603_1608Metric
C10, C11, C12, C13: 1µF; C_0603_1608Metric
D1: IN-S85TATRGB_ALT; IN-S85TATRGB
D2: BLE; LED_0805_2012Metric
FID1, FID2, FID3, FID4: Fiducial; Fiducial_1mm_Mask2mm
J1: ICD Header; ICD3_header
J2: USB4105-GF-A
J3: Left Rails; PinHeader_1x02_P2.54mm_Vertical
J4: Right Rails; PinHeader_1x02_P2.54mm_Vertical
J5: Analog; PinHeader_1x06_P2.54mm_Vertical
J6: Digital; PinHeader_1x06_P2.54mm_Vertical
R1, R3, R10: 909; R_0603_1608Metric
R2, R4, R5, R6, R7, R9: 5.1K; R_0603_1608Metric
R8: 105K; R_0603_1608Metric
R11, R12, R71, R72, R73, R74: 2K; R_0603_1608Metric
S1: RST; KXT321LHS
S2: SW1; KXT321LHS
TP1: REF; TestPoint_THTPad_D1.5mm_Drill0.7mm
TP2: GND; TestPoint_THTPad_D1.5mm_Drill0.7mm
TP3: DAC1; TestPoint_THTPad_D1.5mm_Drill0.7mm
TP4: DAC2; TestPoint_THTPad_D1.5mm_Drill0.7mm
U1: PIC24FJ128GC006-I_MR; pic24fj128gc006_1
U2, U3: ADS8887; TSSOP-10_3x3mm_P0.5mm
U4: DAC8564; TSSOP-16_4.4x5mm_P0.65mm
U5: RN4871
U27: MCP6022; TSSOP-8_4.4x3mm_P0.65mm
Y1: 32K768; Crystal_SMD_2012-2Pin_2.0x1.2mm

Connections:
+3V3: C5.2, C6.2, C7.2, C8.2, C9.1, C10.1, C11.1, C12.1, C13.1, C14.1, C17.1, D1.3, D2.2 (A), J1.2, J6.1, R2.1, R6.1, U1.10 (VDD), U1.19 (AVDD), U1.26 (SVDD), U1.35 (VUSB), U1.38 (VDD), U1.57 (VBAT), U2.2 (AVDD), U2.10 (DVDD), U3.2 (AVDD), U3.10 (DVDD), U4.4 (AVDD), U4.12 (IOVDD), U5.14 (VBAT); also elsewhere on the board
+5V: C69.1, J2.A4B9 (VBUS), J2.B4A9 (VBUS), J3.1, J4.1, J5.1, R8.1, U27.8 (VDD); also elsewhere on the board
/ADC_CONVST: U1.6 (RG8/RP19), U2.6 (CONVST), U3.6 (CONVST)
/ADC_CSN1: U1.32 (RF5/RP17/SCL2), U2.9 (DIN)
/ADC_CSN2: U1.33 (RF3/RP16), U3.9 (DIN)
/ADC_MISO: U1.31 (RF4/RP10/SDA2), U2.7 (DOUT), U3.7 (DOUT)
/ADC_MOSI: U1.29 (RB14/RP14/AN14)
/ADC_SCK: U1.30 (RB15/RP29/AN15), U2.8 (SCK), U3.8 (SCK)
/CH1DUT+: J5.6; also elsewhere on the board
/CH1DUT-: J5.5; also elsewhere on the board
/CH1IN+: U2.3 (AINP); also elsewhere on the board
/CH1IN-: U2.4 (AINN); also elsewhere on the board
/CH1OUT+: U4.8 (VOUTD); also elsewhere on the board
/CH1OUT-: U4.7 (VOUTC); also elsewhere on the board
/CH2DUT+: J5.4; also elsewhere on the board
/CH2DUT-: J5.3; also elsewhere on the board
/CH2IN+: U3.3 (AINP); also elsewhere on the board
/CH2IN-: U3.4 (AINN); also elsewhere on the board
/CH2OUT+: U4.2 (VOUTB); also elsewhere on the board
/CH2OUT-: U4.1 (VOUTA); also elsewhere on the board
/CTS: U1.4 (RG6/RP21), U5.11 (P0_0)
/D0: J6.3, U1.5 (RG7/RP26)
/D1: J6.4, U1.12 (RB4/RP28/AN4)
/D2: J1.5, J6.5, U1.17 (RB6/RP6/AN6/PGEC2)
/D3: J1.4, J6.6, U1.18 (RB7/RP7/AN7/PGED2)
/DAC1: U1.8 (RG9/RP27/DAC1), U27.3
/DAC2: U1.28 (RB13/AN13/DAC2), U27.5
/DAC_CSN: U1.42 (RD8/RP2), U4.9 (~SYNC)
/DAC_MISO: R9.1, U1.43 (RD9/RP4/SDA1)
/DAC_MOSI: U1.44 (RD10/RP3/SCL1), U4.11 (DIN)
/DAC_SCK: U1.45 (RD11/RP12), U4.10 (SCLK)
/ENA12V: U1.39 (RC12/OSCI); also elsewhere on the board
/RD0: U1.46 (RD0/RP11/INT0); also elsewhere on the board
/RD1: U1.49 (RD1/RP24); also elsewhere on the board
/RD2: U1.50 (RD2/RP23); also elsewhere on the board
/RD3: U1.51 (RD3/RP22); also elsewhere on the board
/RD4: U1.52 (RD4/RP25)
/RD5: U1.53 (RD5/RP20); also elsewhere on the board
/RD6: U1.54 (RD6); also elsewhere on the board
/RE0: U1.60 (RE0); also elsewhere on the board
/RE1: U1.61 (RE1); also elsewhere on the board
/RE2: U1.62 (RE2); also elsewhere on the board
/RE3: U1.63 (RE3); also elsewhere on the board
/RE4: U1.64 (RE4)
/RE5: U1.1 (RE5); also elsewhere on the board
/RE6: U1.2 (RE6/SCL3); also elsewhere on the board
/RST_N: U1.3 (RE7/SDA3), U5.10 (RST_N)
/RTS: U1.11 (RB5/RP18/AN5), U5.9 (P3_6)
/RX: U1.15 (RB1/RP1/AN1/VREF-), U5.7 (HCI_RXD)
/RX_IND: U1.27 (RB12/AN12), U5.6 (P1_6)
/TX: U1.14 (RB2/RP13/AN2), U5.8 (HCI_TXD)
/VREF: C15.1, C16.1, R11.1, TP1.1, U1.16 (RB0/RP0/AN0/VREF+), U2.1 (REF), U3.1 (REF), U4.3 (VREFOUT); also elsewhere on the board
/VREFDIV2: R11.2, R12.1; also elsewhere on the board
GND: C1.2, C2.1, C3.1, C4.2, C5.1, C6.1, C7.1, C8.1, C9.2, C10.2, C11.2, C12.2, C13.2, C14.2, C15.2, C16.2, C17.2, C69.2, J1.3, J2.A1B12 (GND), J2.B1A12 (GND), J2.S1 (SHELL), J2.S2 (SHELL), J2.S3 (SHELL), J2.S4 (SHELL), J3.2, J4.2, J5.2, J6.2, R5.2, R7.2, R9.2, R12.2, R72.2, R74.2, S1.1, S2.1, TP2.1, U1.9 (VSS), U1.20 (AVSS), U1.21 (SVSS), U1.41 (VSS), U1.65 (EP), U2.5 (GND), U3.5 (GND), U4.5 (VREFL), U4.6 (GND), U4.13 (A0), U4.14 (A1), U4.15 (~ENABLE), U4.16 (LDAC), U5.2 (GND), U5.13 (GND), U27.4 (VSS); also elsewhere on the board
unnamed: D1.1, R1.1
unnamed: D1.2, R4.1
unnamed: D1.4, R3.1
unnamed: D2.1 (K), R10.1
unnamed: J1.1, R2.2, S1.2, U1.7 (~MCLR)
unnamed: J2.A5 (CC1), R7.1
unnamed: J2.B5 (CC2), R5.1
unnamed: R71.1, TP3.1, U27.1
unnamed: R71.2, R72.1, U27.2
unnamed: R73.1, TP4.1, U27.7
unnamed: R73.2, R74.1, U27.6
unnamed: J2.A6 (D+), J2.B6 (D+), U1.37 (D+)
unnamed: J2.A7 (D-), J2.B7 (D-), U1.36 (D-)
unnamed: C2.2, U1.47 (RC13/SOSCI), Y1.2
unnamed: C3.2, U1.48 (RC14/RPI37/SOSCO), Y1.1
unnamed: R6.2, S2.2, U1.40 (RC15/OSCO)
unnamed: R4.2, U1.55 (RD7)
unnamed: R3.2, U1.58 (RF0)
unnamed: R1.2, U1.59 (RF1)
unnamed: R8.2, U1.34 (VBUS)
unnamed: C1.1, C4.1, U1.56 (VCAP)
unnamed: R10.2, U5.12 (P0_2)

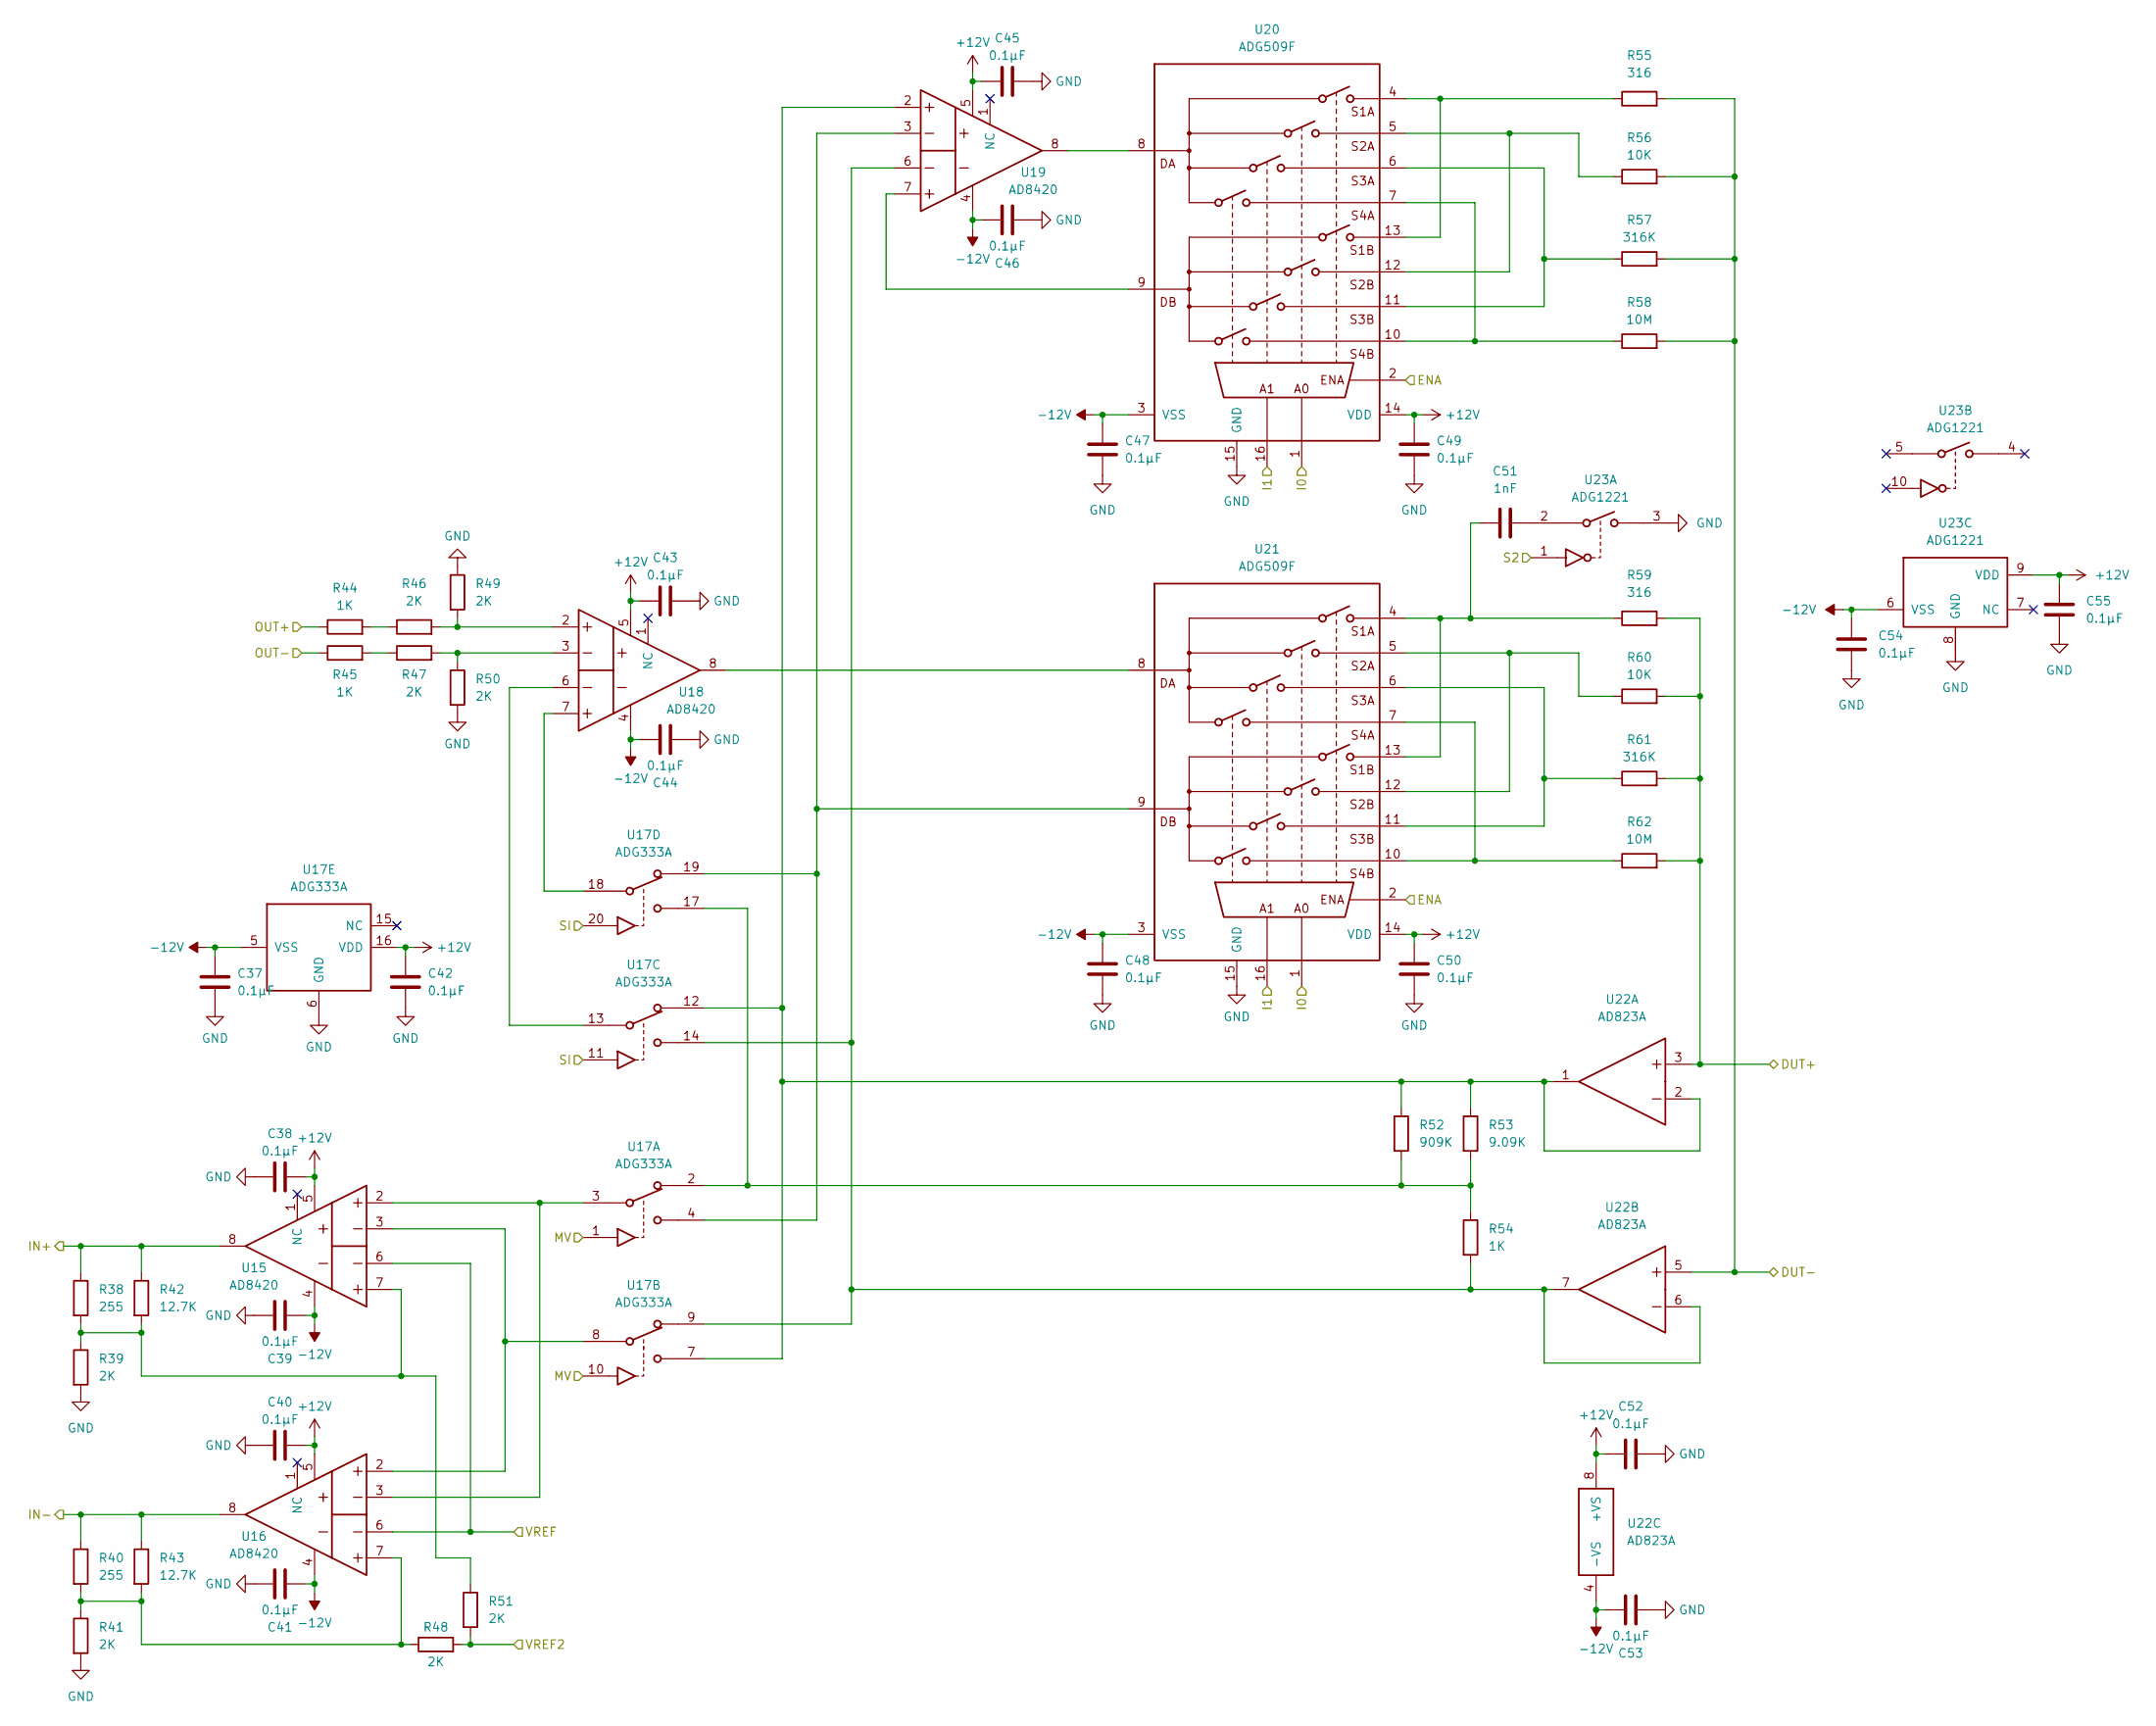
[picture p41: schematic smu_channel.kicad_sch, SMU 2.0]

Parts:
C37, C38, C39, C40, C41, C42, C43, C44, C45, C46, C47, C48, C49, C50, C52, C53, C54, C55: 0.1µF; C_0603_1608Metric
C51: 1nF; C_0603_1608Metric
R38, R40: 255; R_0603_1608Metric
R39, R41, R46, R47, R48, R49, R50, R51: 2K; R_0603_1608Metric
R42, R43: 12.7K; R_0603_1608Metric
R44, R45, R54: 1K; R_0603_1608Metric
R52: 909K; R_0603_1608Metric
R53: 9.09K; R_0603_1608Metric
R55, R59: 316; R_0603_1608Metric
R56, R60: 10K; R_0603_1608Metric
R57, R61: 316K; R_0603_1608Metric
R58, R62: 10M; R_1206_3216Metric
U15, U16, U18, U19: AD8420; MSOP-8_3x3mm_P0.65mm
U17: ADG333A; SSOP-20_5.3x7.2mm_P0.65mm
U20, U21: ADG509F; TSSOP-16_4.4x5mm_P0.65mm
U22: AD823A; MSOP-8_3x3mm_P0.65mm
U23: ADG1221; MSOP-10_3x3mm_P0.5mm

Connections:
+12V: C38.2, C40.2, C42.1, C43.1, C45.1, C49.1, C50.1, C52.1, C55.1, U15.5, U16.5, U17.16 (VDD), U18.5, U19.5, U20.14 (VDD), U21.14 (VDD), U22.8 (+VS), U23.9 (VDD); also elsewhere on the board
-12V: C37.1, C39.2, C41.2, C44.1, C46.1, C47.1, C48.1, C53.1, C54.1, U15.4, U16.4, U17.5 (VSS), U18.4, U19.4, U20.3 (VSS), U21.3 (VSS), U22.4 (-VS), U23.6 (VSS); also elsewhere on the board
/CH2DUT+: R59.2, R60.2, R61.2, R62.2, U22.3; also elsewhere on the board
/CH2DUT-: R55.2, R56.2, R57.2, R58.2, U22.5; also elsewhere on the board
/CH2IN+: R38.1, R42.1, U15.8; also elsewhere on the board
/CH2IN-: R40.1, R43.1, U16.8; also elsewhere on the board
/CH2OUT+: R44.1; also elsewhere on the board
/CH2OUT-: R45.1; also elsewhere on the board
/RE0: U20.1, U21.1; also elsewhere on the board
/RE1: U20.16, U21.16; also elsewhere on the board
/RE2: U17.1, U17.10; also elsewhere on the board
/RE3: U17.11, U17.20; also elsewhere on the board
/RE5: U23.1; also elsewhere on the board
/RE6: U20.2, U21.2; also elsewhere on the board
/VREF: R48.2, R51.2; also elsewhere on the board
/VREFDIV2: U15.6, U16.6; also elsewhere on the board
GND: C37.2, C38.1, C39.1, C40.1, C41.1, C42.2, C43.2, C44.2, C45.2, C46.2, C47.2, C48.2, C49.2, C50.2, C52.2, C53.2, C54.2, C55.2, R39.2, R41.2, R49.1, R50.2, U17.6 (GND), U20.15 (GND), U21.15 (GND), U23.3, U23.8 (GND); also elsewhere on the board
unnamed: C51.1, R59.1, U21.4, U21.13
unnamed: C51.2, U23.2
unnamed: R38.2, R39.1, R42.2, R51.1, U15.7
unnamed: R40.2, R41.1, R43.2, R48.1, U16.7
unnamed: R44.2, R46.1
unnamed: R45.2, R47.1
unnamed: R46.2, R49.2, U18.2
unnamed: R47.2, R50.1, U18.3
unnamed: R52.1, R53.1, U17.7, U17.12, U19.2, U22.1, U22.2
unnamed: R52.2, R53.2, R54.1, U17.2, U17.17
unnamed: R54.2, U17.9, U17.14, U19.6, U22.6, U22.7
unnamed: R55.1, U20.4, U20.13
unnamed: R56.1, U20.5, U20.12
unnamed: R57.1, U20.6, U20.11
unnamed: R58.1, U20.7, U20.10
unnamed: R60.1, U21.5, U21.12
unnamed: R61.1, U21.6, U21.11
unnamed: R62.1, U21.7, U21.10
unnamed: U15.2, U16.3, U17.3
unnamed: U15.3, U16.2, U17.8
unnamed: U17.13, U18.6
unnamed: U17.18, U18.7
unnamed: U17.4, U17.19, U19.3, U21.9
unnamed: U18.8, U21.8
unnamed: U19.7, U20.9
unnamed: U19.8, U20.8

Parts of its further copies:
C18, C19, C20, C21, C22, C23, C24, C25, C26, C27, C28, C29, C30, C31, C33, C34, C35, C36: 0.1µF; C_0603_1608Metric
C32: 1nF; C_0603_1608Metric
R13, R15: 255; R_0603_1608Metric
R14, R16, R21, R22, R23, R24, R25, R26: 2K; R_0603_1608Metric
R17, R18: 12.7K; R_0603_1608Metric
R19, R20, R29: 1K; R_0603_1608Metric
R27: 909K; R_0603_1608Metric
R28: 9.09K; R_0603_1608Metric
R30, R34: 316; R_0603_1608Metric
R31, R35: 10K; R_0603_1608Metric
R32, R36: 316K; R_0603_1608Metric
R33, R37: 10M; R_1206_3216Metric
U6, U7, U9, U10: AD8420; MSOP-8_3x3mm_P0.65mm
U8: ADG333A; SSOP-20_5.3x7.2mm_P0.65mm
U11, U12: ADG509F; TSSOP-16_4.4x5mm_P0.65mm
U13: AD823A; MSOP-8_3x3mm_P0.65mm
U14: ADG1221; MSOP-10_3x3mm_P0.5mm

Connections of its further copies:
+12V: C19.2, C21.2, C23.1, C24.1, C26.1, C30.1, C31.1, C33.1, C36.1, U6.5, U7.5, U8.16 (VDD), U9.5, U10.5, U11.14 (VDD), U12.14 (VDD), U13.8 (+VS), U14.9 (VDD); also elsewhere on the board
-12V: C18.1, C20.2, C22.2, C25.1, C27.1, C28.1, C29.1, C34.1, C35.1, U6.4, U7.4, U8.5 (VSS), U9.4, U10.4, U11.3 (VSS), U12.3 (VSS), U13.4 (-VS), U14.6 (VSS); also elsewhere on the board
/CH1DUT+: R34.2, R35.2, R36.2, R37.2, U13.3; also elsewhere on the board
/CH1DUT-: R30.2, R31.2, R32.2, R33.2, U13.5; also elsewhere on the board
/CH1IN+: R13.1, R17.1, U6.8; also elsewhere on the board
/CH1IN-: R15.1, R18.1, U7.8; also elsewhere on the board
/CH1OUT+: R19.1; also elsewhere on the board
/CH1OUT-: R20.1; also elsewhere on the board
/RD0: U11.1, U12.1; also elsewhere on the board
/RD1: U11.16, U12.16; also elsewhere on the board
/RD2: U8.1, U8.10; also elsewhere on the board
/RD3: U8.11, U8.20; also elsewhere on the board
/RD5: U14.1; also elsewhere on the board
/RD6: U11.2, U12.2; also elsewhere on the board
/VREF: R23.2, R26.2; also elsewhere on the board
/VREFDIV2: U6.6, U7.6; also elsewhere on the board
GND: C18.2, C19.1, C20.1, C21.1, C22.1, C23.2, C24.2, C25.2, C26.2, C27.2, C28.2, C29.2, C30.2, C31.2, C33.2, C34.2, C35.2, C36.2, R14.2, R16.2, R24.1, R25.2, U8.6 (GND), U11.15 (GND), U12.15 (GND), U14.3, U14.8 (GND); also elsewhere on the board
unnamed: C32.1, R34.1, U12.4, U12.13
unnamed: C32.2, U14.2
unnamed: R13.2, R14.1, R17.2, R26.1, U6.7
unnamed: R15.2, R16.1, R18.2, R23.1, U7.7
unnamed: R19.2, R21.1
unnamed: R20.2, R22.1
unnamed: R21.2, R24.2, U9.2
unnamed: R22.2, R25.1, U9.3
unnamed: R27.1, R28.1, U8.7, U8.12, U10.2, U13.1, U13.2
unnamed: R27.2, R28.2, R29.1, U8.2, U8.17
unnamed: R29.2, U8.9, U8.14, U10.6, U13.6, U13.7
unnamed: R30.1, U11.4, U11.13
unnamed: R31.1, U11.5, U11.12
unnamed: R32.1, U11.6, U11.11
unnamed: R33.1, U11.7, U11.10
unnamed: R35.1, U12.5, U12.12
unnamed: R36.1, U12.6, U12.11
unnamed: R37.1, U12.7, U12.10
unnamed: U6.2, U7.3, U8.3
unnamed: U6.3, U7.2, U8.8
unnamed: U8.13, U9.6
unnamed: U8.18, U9.7
unnamed: U8.4, U8.19, U10.3, U12.9
unnamed: U10.7, U11.9
unnamed: U10.8, U11.8
unnamed: U9.8, U12.8

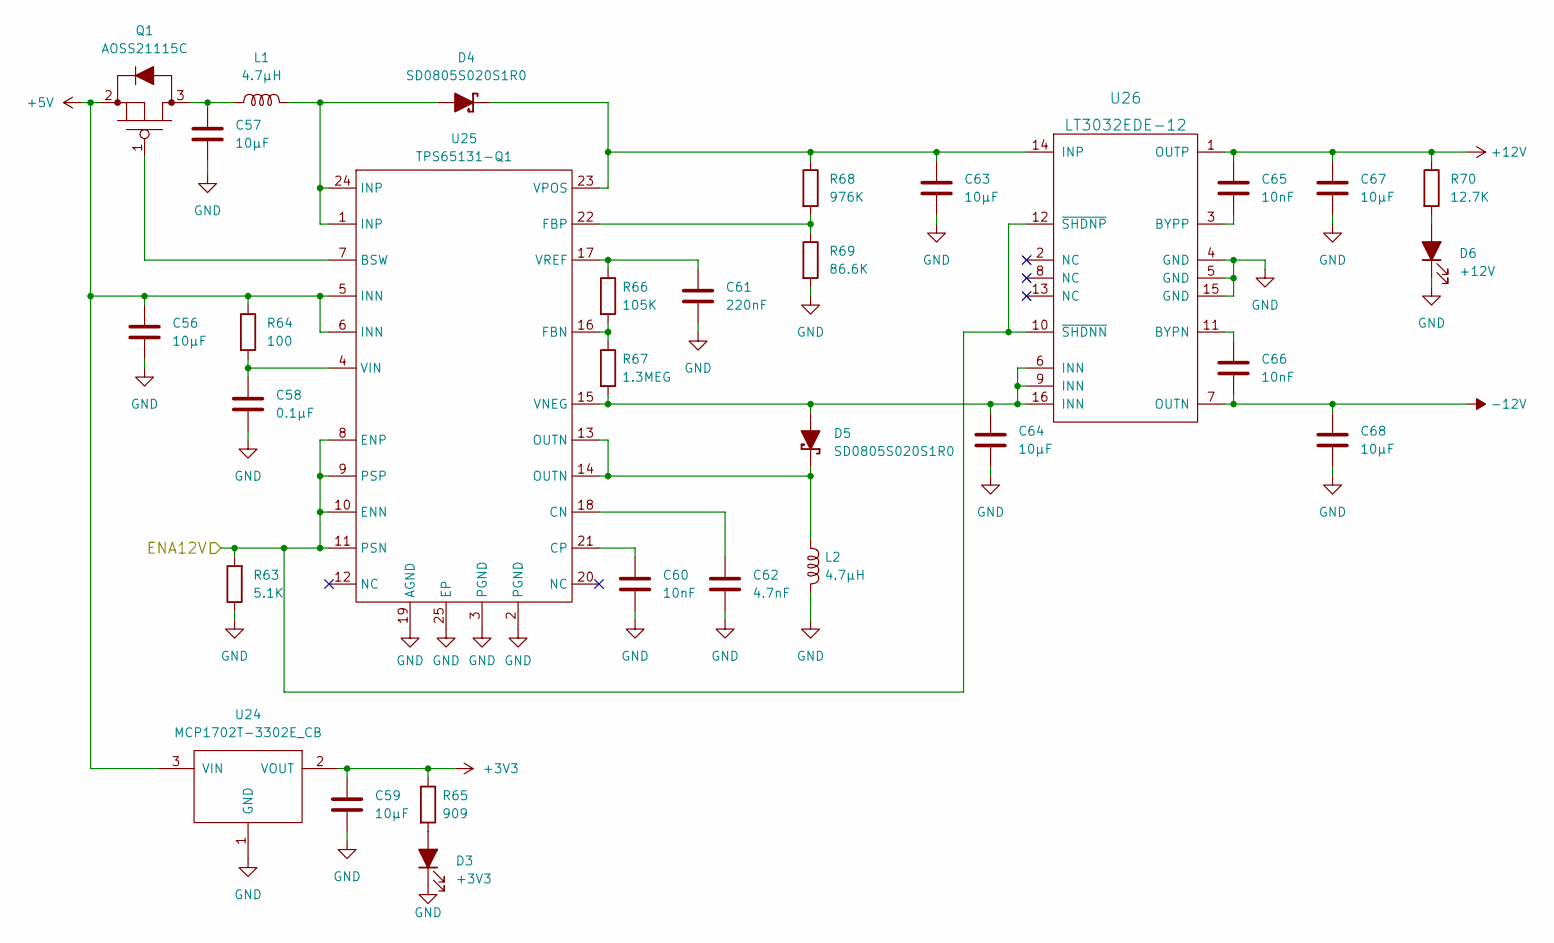
[picture p42: schematic power_supply.kicad_sch, SMU 2.0]

Parts:
C56, C57, C59, C63, C64, C67, C68: 10µF; C_0603_1608Metric
C58: 0.1µF; C_0603_1608Metric
C60, C65, C66: 10nF; C_0603_1608Metric
C61: 220nF; C_0603_1608Metric
C62: 4.7nF; C_0603_1608Metric
D3: +3V3; LED_0805_2012Metric
D4, D5: SD0805S020S1R0; D_0805_2012Metric
D6: +12V; LED_0805_2012Metric
L1, L2: 4.7µH; PA5003.182NLT
Q1: AOSS21115C; SOT-23
R63: 5.1K; R_0603_1608Metric
R64: 100; R_0603_1608Metric
R65: 909; R_0603_1608Metric
R66: 105K; R_0603_1608Metric
R67: 1.3MEG; R_0603_1608Metric
R68: 976K; R_0603_1608Metric
R69: 86.6K; R_0603_1608Metric
R70: 12.7K; R_0603_1608Metric
U24: MCP1702T-3302E_CB; SOT-23
U25: TPS65131-Q1; TPS65131-Q_1
U26: LT3032EDE-12; LT3032_1

Connections:
+3V3: C59.1, R65.1, U24.2 (VOUT); also elsewhere on the board
+5V: C56.1, Q1.2, R64.1, U24.3 (VIN), U25.5 (INN), U25.6 (INN); also elsewhere on the board
+12V: C65.1, C67.1, R70.1, U26.1 (OUTP); also elsewhere on the board
-12V: C66.2, C68.1, U26.7 (OUTN); also elsewhere on the board
/ENA12V: R63.2, U25.8 (ENP), U25.9 (PSP), U25.10 (ENN), U25.11 (PSN), U26.10 (~SHDNN), U26.12 (~SHDNP); also elsewhere on the board
GND: C56.2, C57.2, C58.2, C59.2, C60.2, C61.2, C62.2, C63.2, C64.2, C67.2, C68.2, D3.1 (K), D6.1 (K), L2.2, R63.1, R69.2, U24.1 (GND), U25.2 (PGND), U25.3 (PGND), U25.19 (AGND), U25.25 (EP), U26.4 (GND), U26.5 (GND), U26.15 (GND); also elsewhere on the board
unnamed: C57.1, L1.1, Q1.3
unnamed: D3.2 (A), R65.2
unnamed: D4.2, L1.2, U25.1 (INP), U25.24 (INP)
unnamed: D5.1, L2.1, U25.13 (OUTN), U25.14 (OUTN)
unnamed: D6.2 (A), R70.2
unnamed: Q1.1, U25.7 (BSW)
unnamed: C62.1, U25.18 (CN)
unnamed: C60.1, U25.21 (CP)
unnamed: R66.2, R67.1, U25.16 (FBN)
unnamed: R68.2, R69.1, U25.22 (FBP)
unnamed: C58.1, R64.2, U25.4 (VIN)
unnamed: C64.1, D5.2, R67.2, U25.15 (VNEG), U26.6 (INN), U26.9 (INN), U26.16 (INN)
unnamed: C63.1, D4.1, R68.1, U25.23 (VPOS), U26.14 (INP)
unnamed: C61.1, R66.1, U25.17 (VREF)
unnamed: C66.1, U26.11 (BYPN)
unnamed: C65.2, U26.3 (BYPP)

Parts of its further copies:
C22: 0.1µF; C_0603_1608Metric

Connections of its further copies:
-12V: C22.2; also elsewhere on the board
GND: C22.1; also elsewhere on the board

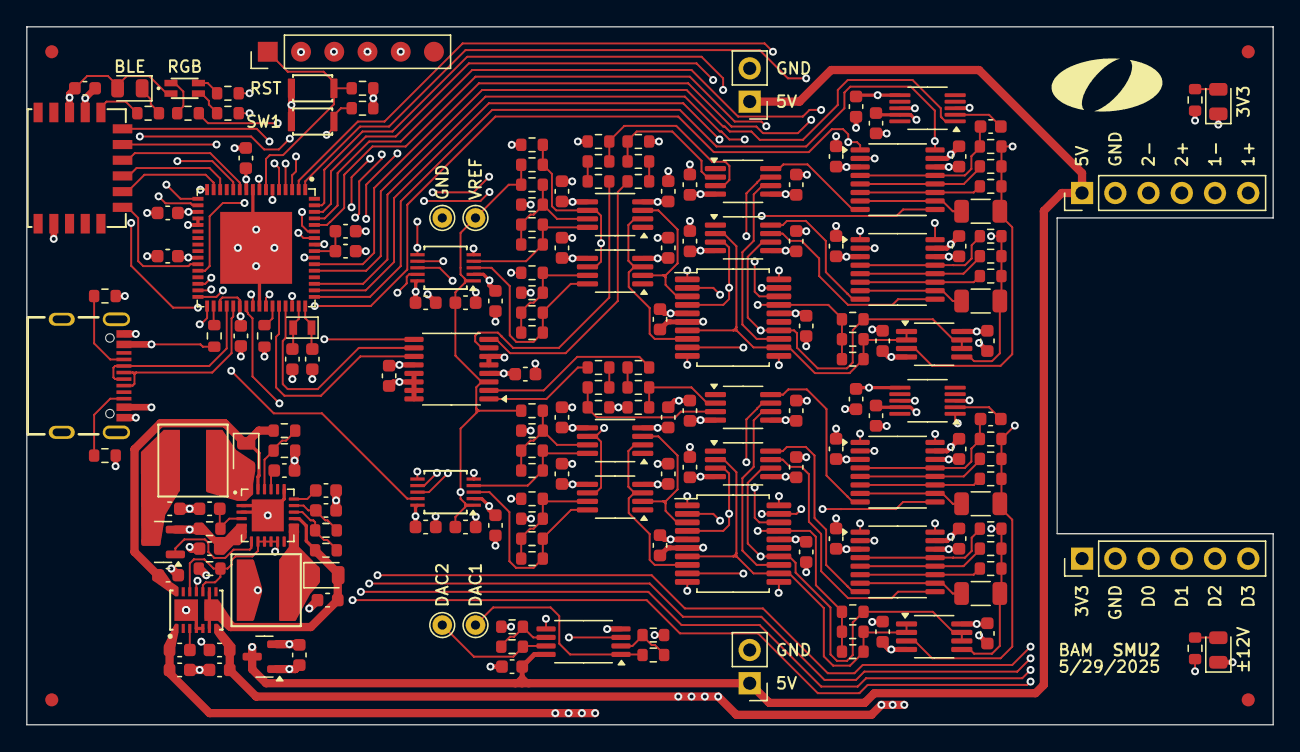
[picture p43: board smu2.kicad_pcb from above]

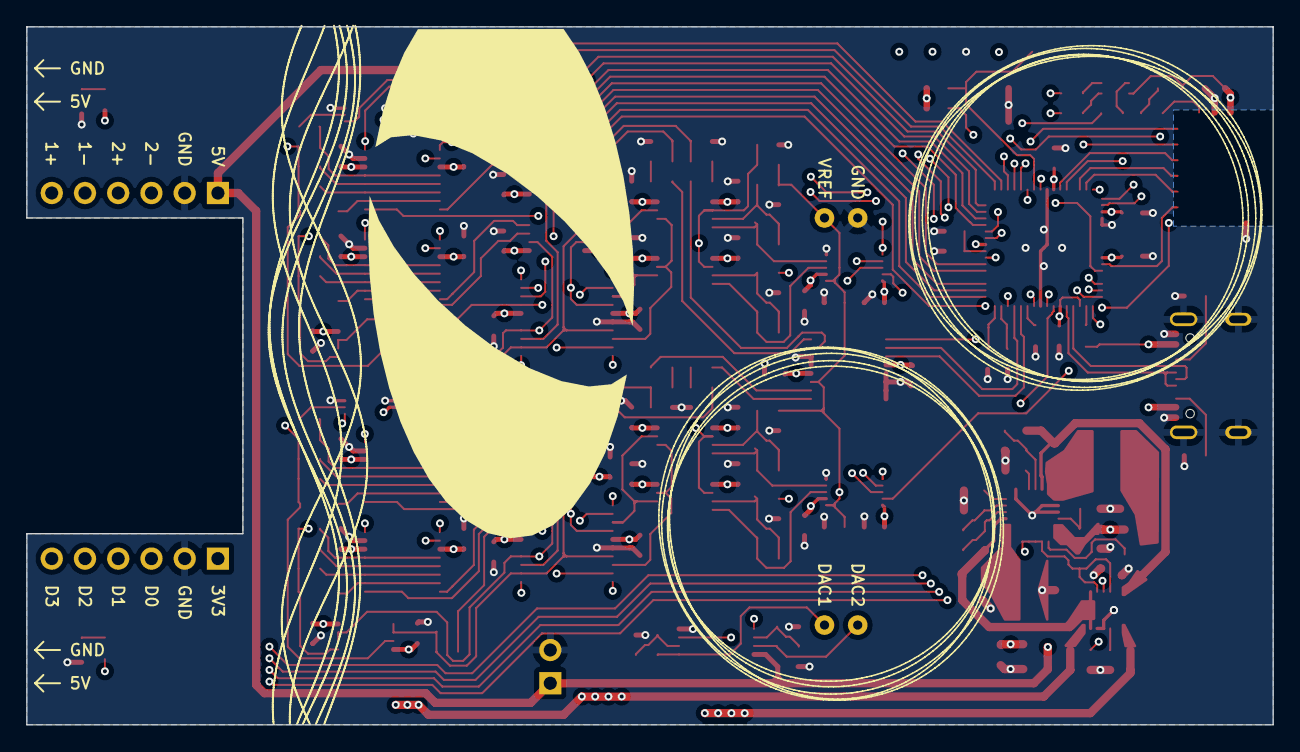
[picture p44: board smu2.kicad_pcb from below]

Board: 4 copper layers, 95.2 x 53.3 mm, 200 parts (3 on the bottom side), 143 nets.

Other parts of the board:
OlinLogoLg1: G***; OlinLogoLg1
OlinLogoTruncated: G***; OlinLogoTruncated
svg2mod, svg2mod#2: G***; gesture_ellipse
