bminch/smu2/(commit log)

2025-06-17 Add board files.
    [1725656.stp, 219-3M.STEP, 3382g-001-xxx.stp, 5442565.stp, ABM10.STP, ABS06-107.STP, Analog_Devices_Inc_-_ADXL362BCCZ.step, B4B-XH-A.step]
2025-06-20 Changed R4 from 909Ω to 5.1kΩ
    [smu2.kicad_pcb, smu2.kicad_sch, smu2_BoM.ods]
